mirdej/tvtools/maxmsp/Support/DSC01300.JPG

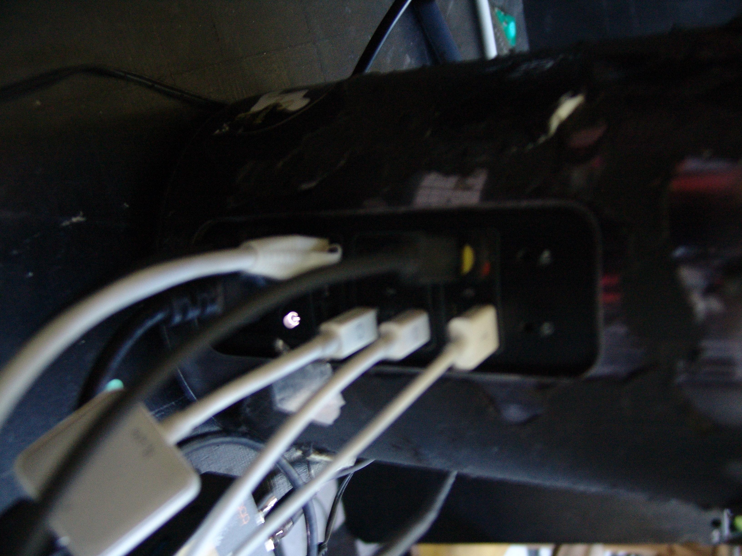
maxmsp/Support/DSC01300.JPG
