mirdej/tvtools/firmware/Lights/README.md

# Anyma ESP32-S3 Blink

Maybe the most complicated Arduino Blink Sketch in the world

## Dependencies
- FastLed: 	fastled/FastLED@^3.6.0
- ArduinoJSON: blanchon/ArduinoJson@^7.0.4
- aWOT Web server Library: 	lasselukkari/aWOT@^3.5.0
- FTP-Server: 	peterus/ESP-FTP-Server-Lib@^0.14.1
