mirdej/tvtools/kicad/tv.buzzer2022/tv.buzzer2022-Edge_Cuts.dxf

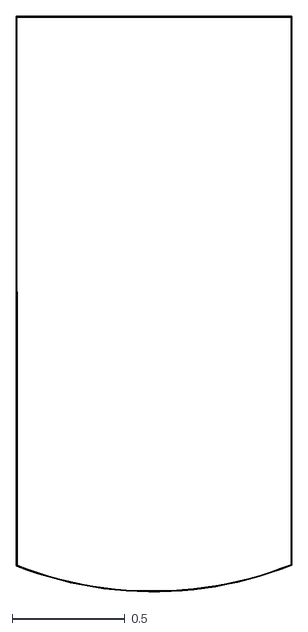
[picture p2: CAD file, 2024-05-06]
kicad/tv.buzzer2022/tv.buzzer2022-Edge_Cuts.dxf
1.22 x 2.55
