mirdej/tvtools/kicad/tv.buzzer3.0/buzzer3.0-B_Cu.dxf

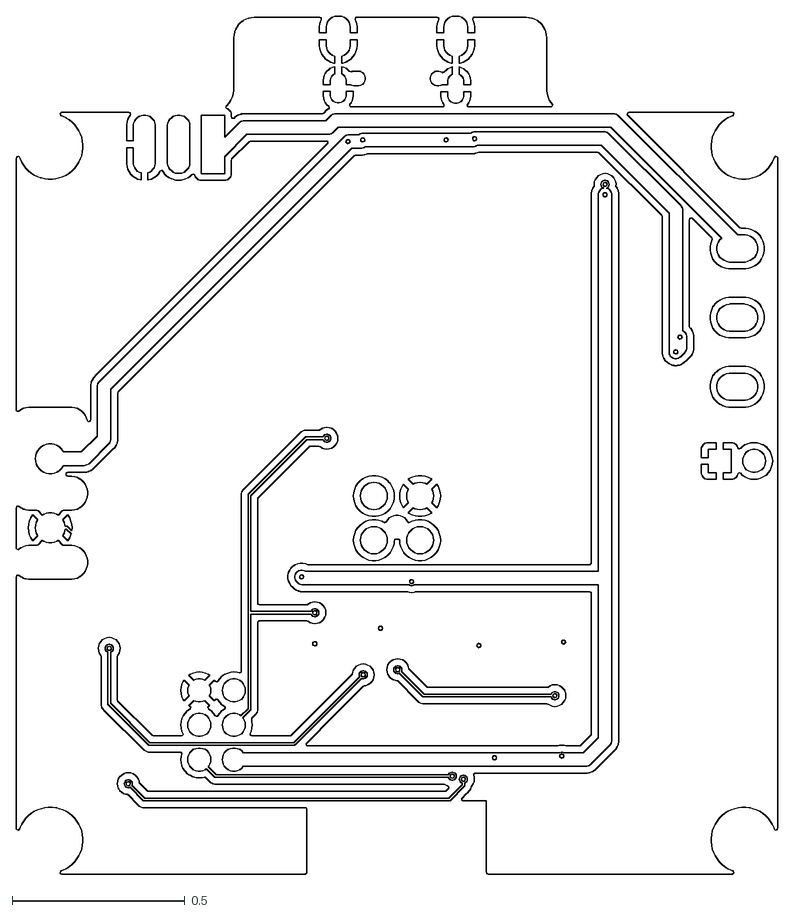
[picture p3: CAD file, 2025-04-22]
kicad/tv.buzzer3.0/buzzer3.0-B_Cu.dxf
2.20 x 2.48
