mirdej/tvtools/sketchup/steckerschlange6-flex-smaller.3mf

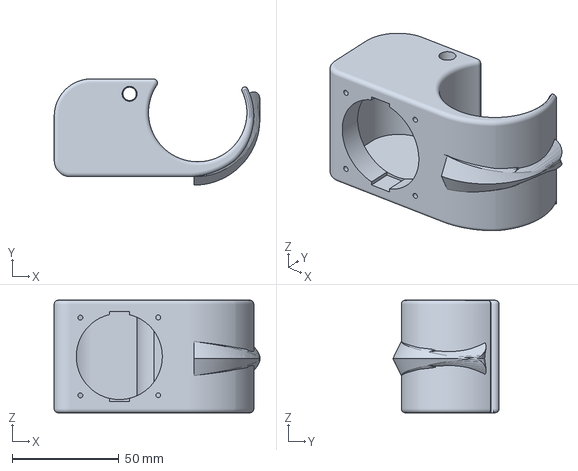
[picture p4: CAD file, 2024-05-06]
sketchup/steckerschlange6-flex-smaller.3mf
96.6 x 49.8 x 52.8 mm
