mirdej/tvtools/kicad/tv.buzzer2022/tv.buzzer2022-B_Cu.dxf

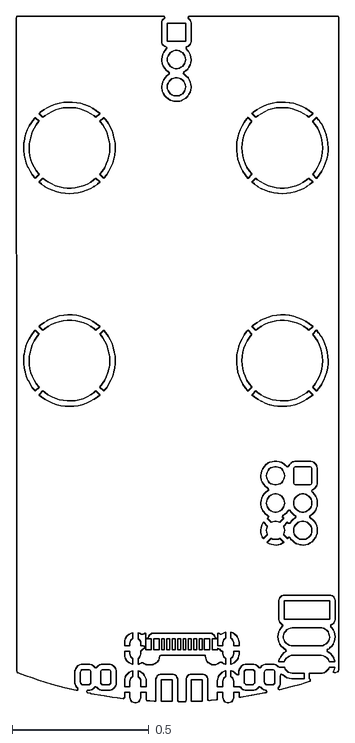
[picture p5: CAD file, 2024-05-06]
kicad/tv.buzzer2022/tv.buzzer2022-B_Cu.dxf
1.18 x 2.51
