mirdej/tvtools/sketchup/steckerschlange6-flex-smaller2.stl

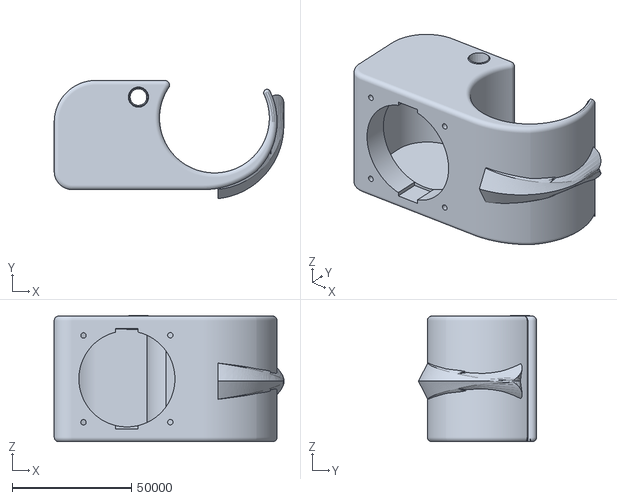
[picture p7: CAD file, 2024-05-06]
sketchup/steckerschlange6-flex-smaller2.stl
96590.7 x 49657.1 x 53116.8
