mirdej/tvtools/kicad/tv.buzzer2022/tv.buzzer2022-F_Cu.dxf

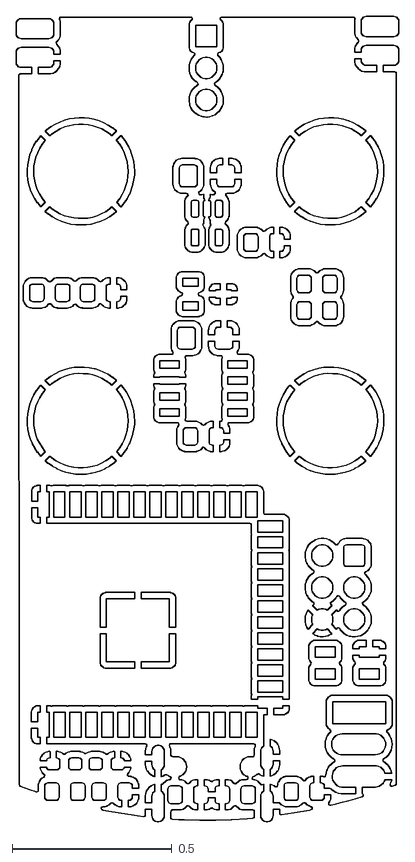
[picture p8: CAD file, 2024-05-06]
kicad/tv.buzzer2022/tv.buzzer2022-F_Cu.dxf
1.20 x 2.52
