mirdej/tvtools/kicad/tv.buzzer3.0/buzzer3.0-Edge_Cuts.dxf

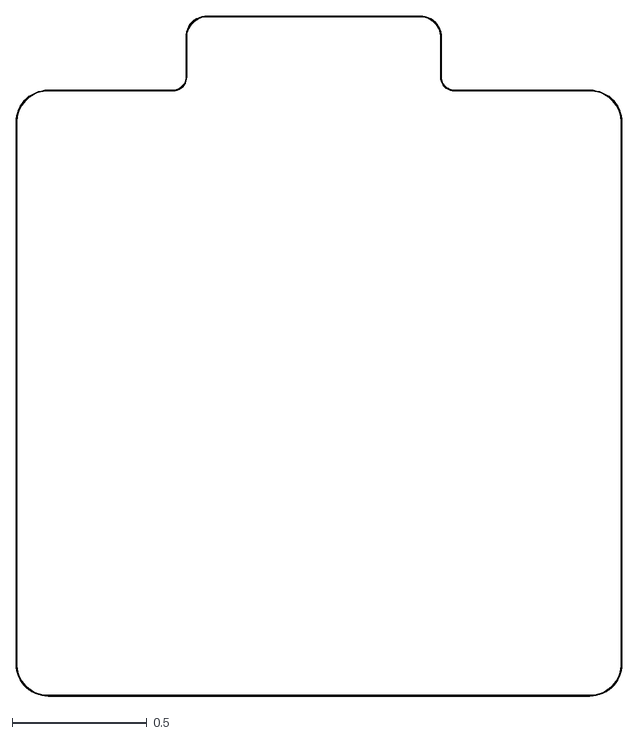
[picture p9: CAD file, 2025-04-22]
kicad/tv.buzzer3.0/buzzer3.0-Edge_Cuts.dxf
2.25 x 2.52
