mirdej/tvtools/(list of files, cad)

Other CAD files:
kicad/tv.buzzer2022/tv.buzzer2022-B_Mask.dxf
kicad/tv.buzzer2022/tv.buzzer2022-B_Paste.dxf
kicad/tv.buzzer2022/tv.buzzer2022-B_Silkscreen.dxf
kicad/tv.buzzer2022/tv.buzzer2022-F_Mask.dxf
kicad/tv.buzzer2022/tv.buzzer2022-F_Paste.dxf
kicad/tv.buzzer2022/tv.buzzer2022-F_Silkscreen.dxf
kicad/tv.buzzer3.0/buzzer3.0-B_Mask.dxf
kicad/tv.buzzer3.0/buzzer3.0-B_Paste.dxf
kicad/tv.buzzer3.0/buzzer3.0-B_Silkscreen.dxf
kicad/tv.buzzer3.0/buzzer3.0-F_Mask.dxf
kicad/tv.buzzer3.0/buzzer3.0-F_Paste.dxf
kicad/tv.buzzer3.0/buzzer3.0-F_Silkscreen.dxf
sketchup/ClipController23.skp
sketchup/ClipController23~.skp
sketchup/RecorderRack.skp
sketchup/SwitcherController-Enclosure.skp
sketchup/steckerschlange6-flex-smaller.skp
