mirdej/tvtools/kicad/DeckController-Hardware/DeckController-Hardware-B.Cu.pdf

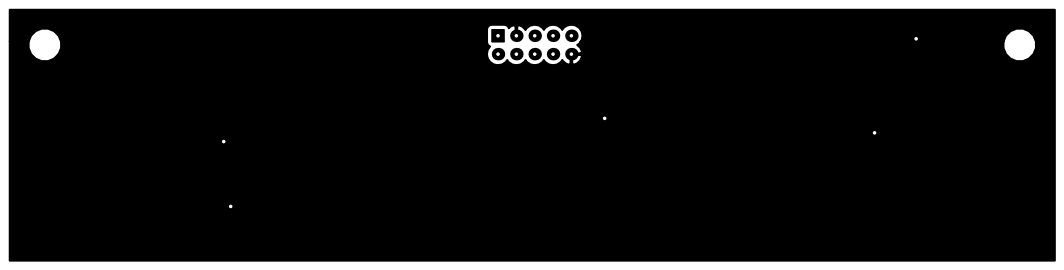
[picture p10: page 1]
