mirdej/tvtools/kicad/DeckController-Hardware/DeckController-Hardware-F.Cu.pdf

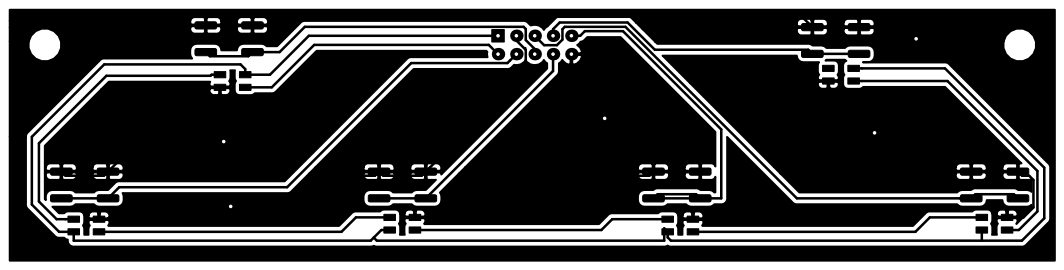
[picture p11: page 1]
