mirdej/tvtools/kicad/DeckController-Hardware/DeckController-Hardware-F.Mask.pdf

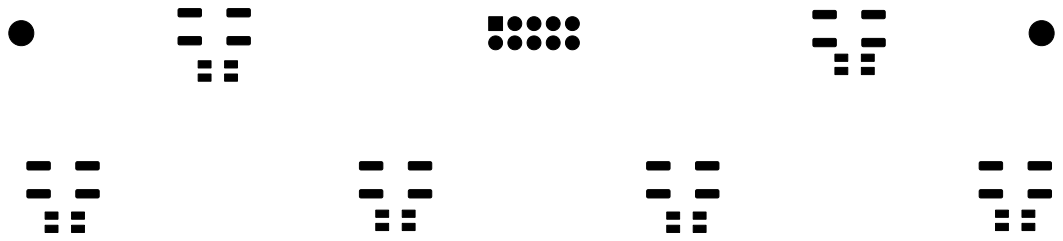
[picture p12: page 1]
