mirdej/tvtools/kicad/DeckController-Hardware/DeckController-Hardware-F.Paste.pdf

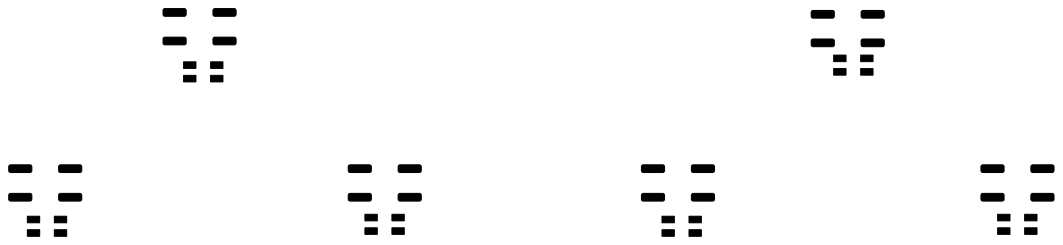
[picture p13: page 1]
