mirdej/tvtools/kicad/DeckController-Hardware/DeckController-Hardware-F.SilkS.pdf

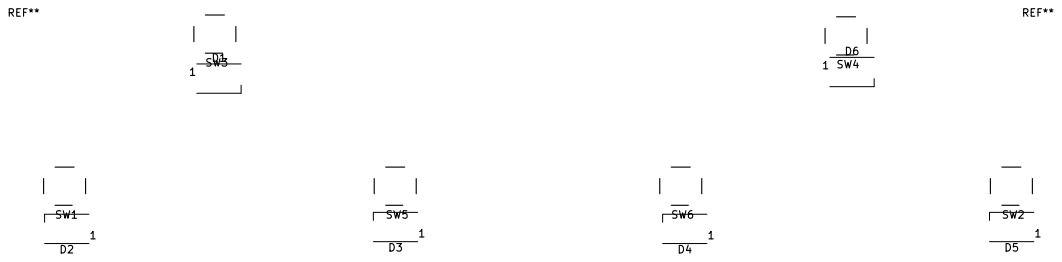
[picture p14: page 1]
