mirdej/tvtools/kicad/tv.controller2025/tv25-cpu-small/tv25-cpu-small.kicad_pcb

## KiCad design kicad/tv.controller2025/tv25-cpu-small/tv25-cpu-small.kicad_pcb (2025-05-29)

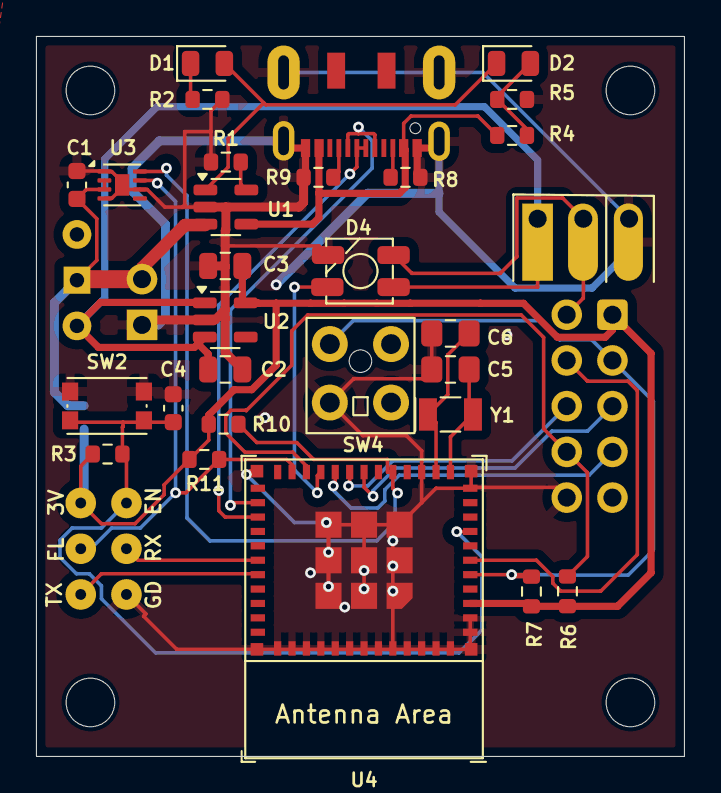
[picture p15: board tv25-cpu-small.kicad_pcb from above]

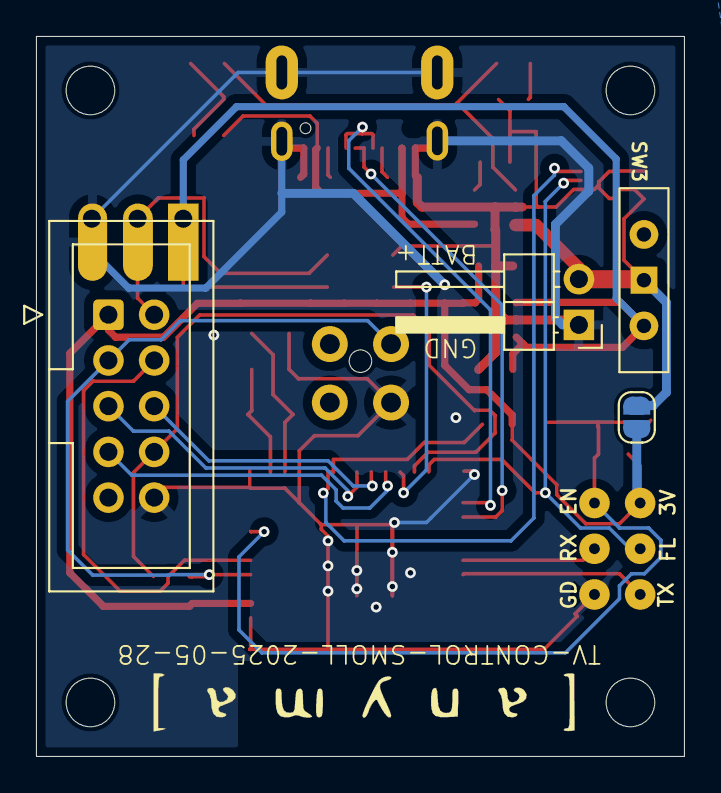
[picture p16: board tv25-cpu-small.kicad_pcb from below]

Board: 2 copper layers, 36.0 x 40.0 mm, 39 parts (5 on the bottom side), 28 nets.

Parts:
C1: 100n; C_0603_1608Metric
C2: 10u; C_0805_2012Metric
C3: 4u7; C_0805_2012Metric
C4: 1u; C_0603_1608Metric
C5, C6: 10p; C_0805_2012Metric_Pad1.18x1.45mm_HandSolder
D1: RDY; LED_0805_2012Metric
D2: CHRG; LED_0805_2012Metric
D4: SK6812MINI; SK6812-MINI-HS
H1, H2, H3, H4: MountingHole; MountingHole_2.7mm_M2.5
J1: BATT; PinHeader_1x02_P2.54mm_Horizontal
J2: Conn_01x10; IDC-Header_2x05_P2.54mm_Vertical
J3: Prog; ESP-POGO-PROG-THT
J4: USB_C_Receptacle_USB2.0; JAE_USB-C_SJ122205
J11: pixels; ComboPinhead_03
JP1: cell-powered; SolderJumper-2_P1.3mm_Open_RoundedPad1.0x1.5mm
R1, R2, R4, R5: 2k; R_0603_1608Metric
R3, R6, R7, R8, R9, R10, R11: 5k1; R_0603_1608Metric
SW2: Reset; SW_Push_1P1T_NO_CK_KMR2
SW3: SW_SPDT; SW_Slide-03_Wuerth-WS-SLTV_10x2.5x6.4_P2.54mm
SW4: Btn-1; DDS001
U1: MCP73831-2-OT; SOT-23-5
U2: XC6220B331MR; SOT-23-5
U3: TDFN-8-1EP_2x2mm_P0.5mm_EP0.8x1.2mm
U4: ESP32-C3-MINI-1
U5: LOGO; logo_anyma
Y1: 32.768khz; Crystal_SMD_G8-2Pin_3.2x1.5mm

Connections:
+3V3: C3.1, J2.1, J3.1, JP1.2 (B), R3.1, R6.1, R7.1, R10.1, R11.1, U2.5 (VOUT), U4.3 (3V3)
+3V8: C2.1, D4.4 (VDD), J11.1, SW3.2 (B), U2.1 (VIN), U2.3 (CE)
+5V: J4.A4 (VBUS), J4.A9 (VBUS), R4.1, U1.4 (VDD)
+BATT: C1.1, J1.2, JP1.1 (A), SW3.1 (A), U1.3 (VBAT), U3.2 (CELL), U3.3 (VDD)
/en: C4.1, J3.2, R3.2, SW2.2, U4.8 (EN/CHIP_PU)
/gpio_8: J2.8, R6.2, U4.22 (GPIO8)
/pix: D4.3 (DIN), U4.21 (GPIO7)
/pixout: D4.1 (DOUT), J2.2, J11.2
/rx: J3.4, U4.30 (GPIO20/U0RXD)
/scl/flash: J3.3, R11.2, U3.7 (SCL), U4.23 (GPIO9)
/sda: R10.2, U3.8 (SDA), U4.16 (GPIO10)
/strap2: J2.3, R7.2, SW4.1, U4.5 (GPIO2/ADC1_CH2)
/tx: J3.5, U4.31 (GPIO21/U0TXD)
/usb+: J4.A6 (D+), J4.B6 (D+), U4.27 (GPIO19/USB_D+)
/usb-: J4.A7 (D-), J4.B7 (D-), U4.26 (GPIO18/USB_D-)
GND: C1.2, C2.2, C3.2, C4.2, C5.1, C6.1, D4.2 (VSS), J1.1, J2.10, J3.6, J4.A1 (GND), J4.A12 (GND), J4.S1 (SHIELD), J11.3, R1.2, R2.2, R5.2, R8.2, R9.2, SW2.1, SW4.2, U1.2 (VSS), U2.2 (GND), U3.1 (CTG), U3.4 (GND), U3.6 (QSTRT), U3.9 (EP), U4.1 (GND), U4.2 (GND), U4.11 (GND), U4.14 (GND), U4.36 (GND), U4.37 (GND), U4.38 (GND), U4.39 (GND), U4.40 (GND), U4.41 (GND), U4.42 (GND), U4.43 (GND), U4.44 (GND), U4.45 (GND), U4.46 (GND), U4.47 (GND), U4.48 (GND), U4.49 (GND), U4.50 (GND), U4.51 (GND), U4.52 (GND), U4.53 (GND)
unnamed: D1.2 (A), D2.1 (K), U1.1 (STAT)
unnamed: D1.1 (K), R2.1
unnamed: D2.2 (A), R4.2, R5.1
unnamed: J2.4, U4.6 (GPIO3/ADC1_CH3)
unnamed: J2.5, U4.18 (GPIO4/ADC1_CH4)
unnamed: J2.6, U4.19 (GPIO5/ADC2_CH0)
unnamed: J2.7, U4.20 (GPIO6)
unnamed: J4.A5 (CC1), R8.1
unnamed: J4.B5 (CC2), R9.1
unnamed: R1.1, U1.5 (PROG)
unnamed: C5.2, U4.12 (GPIO0/ADC1_CH0/XTAL_32K_P), Y1.2
unnamed: C6.2, U4.13 (GPIO1/ADC1_CH1/XTAL_32K_N), Y1.1
