mirdej/tvtools/kicad/tv.controller2025/tv25-cpu/tv25-cpu.kicad_pcb

## KiCad design kicad/tv.controller2025/tv25-cpu/tv25-cpu.kicad_pcb (2025-04-22)

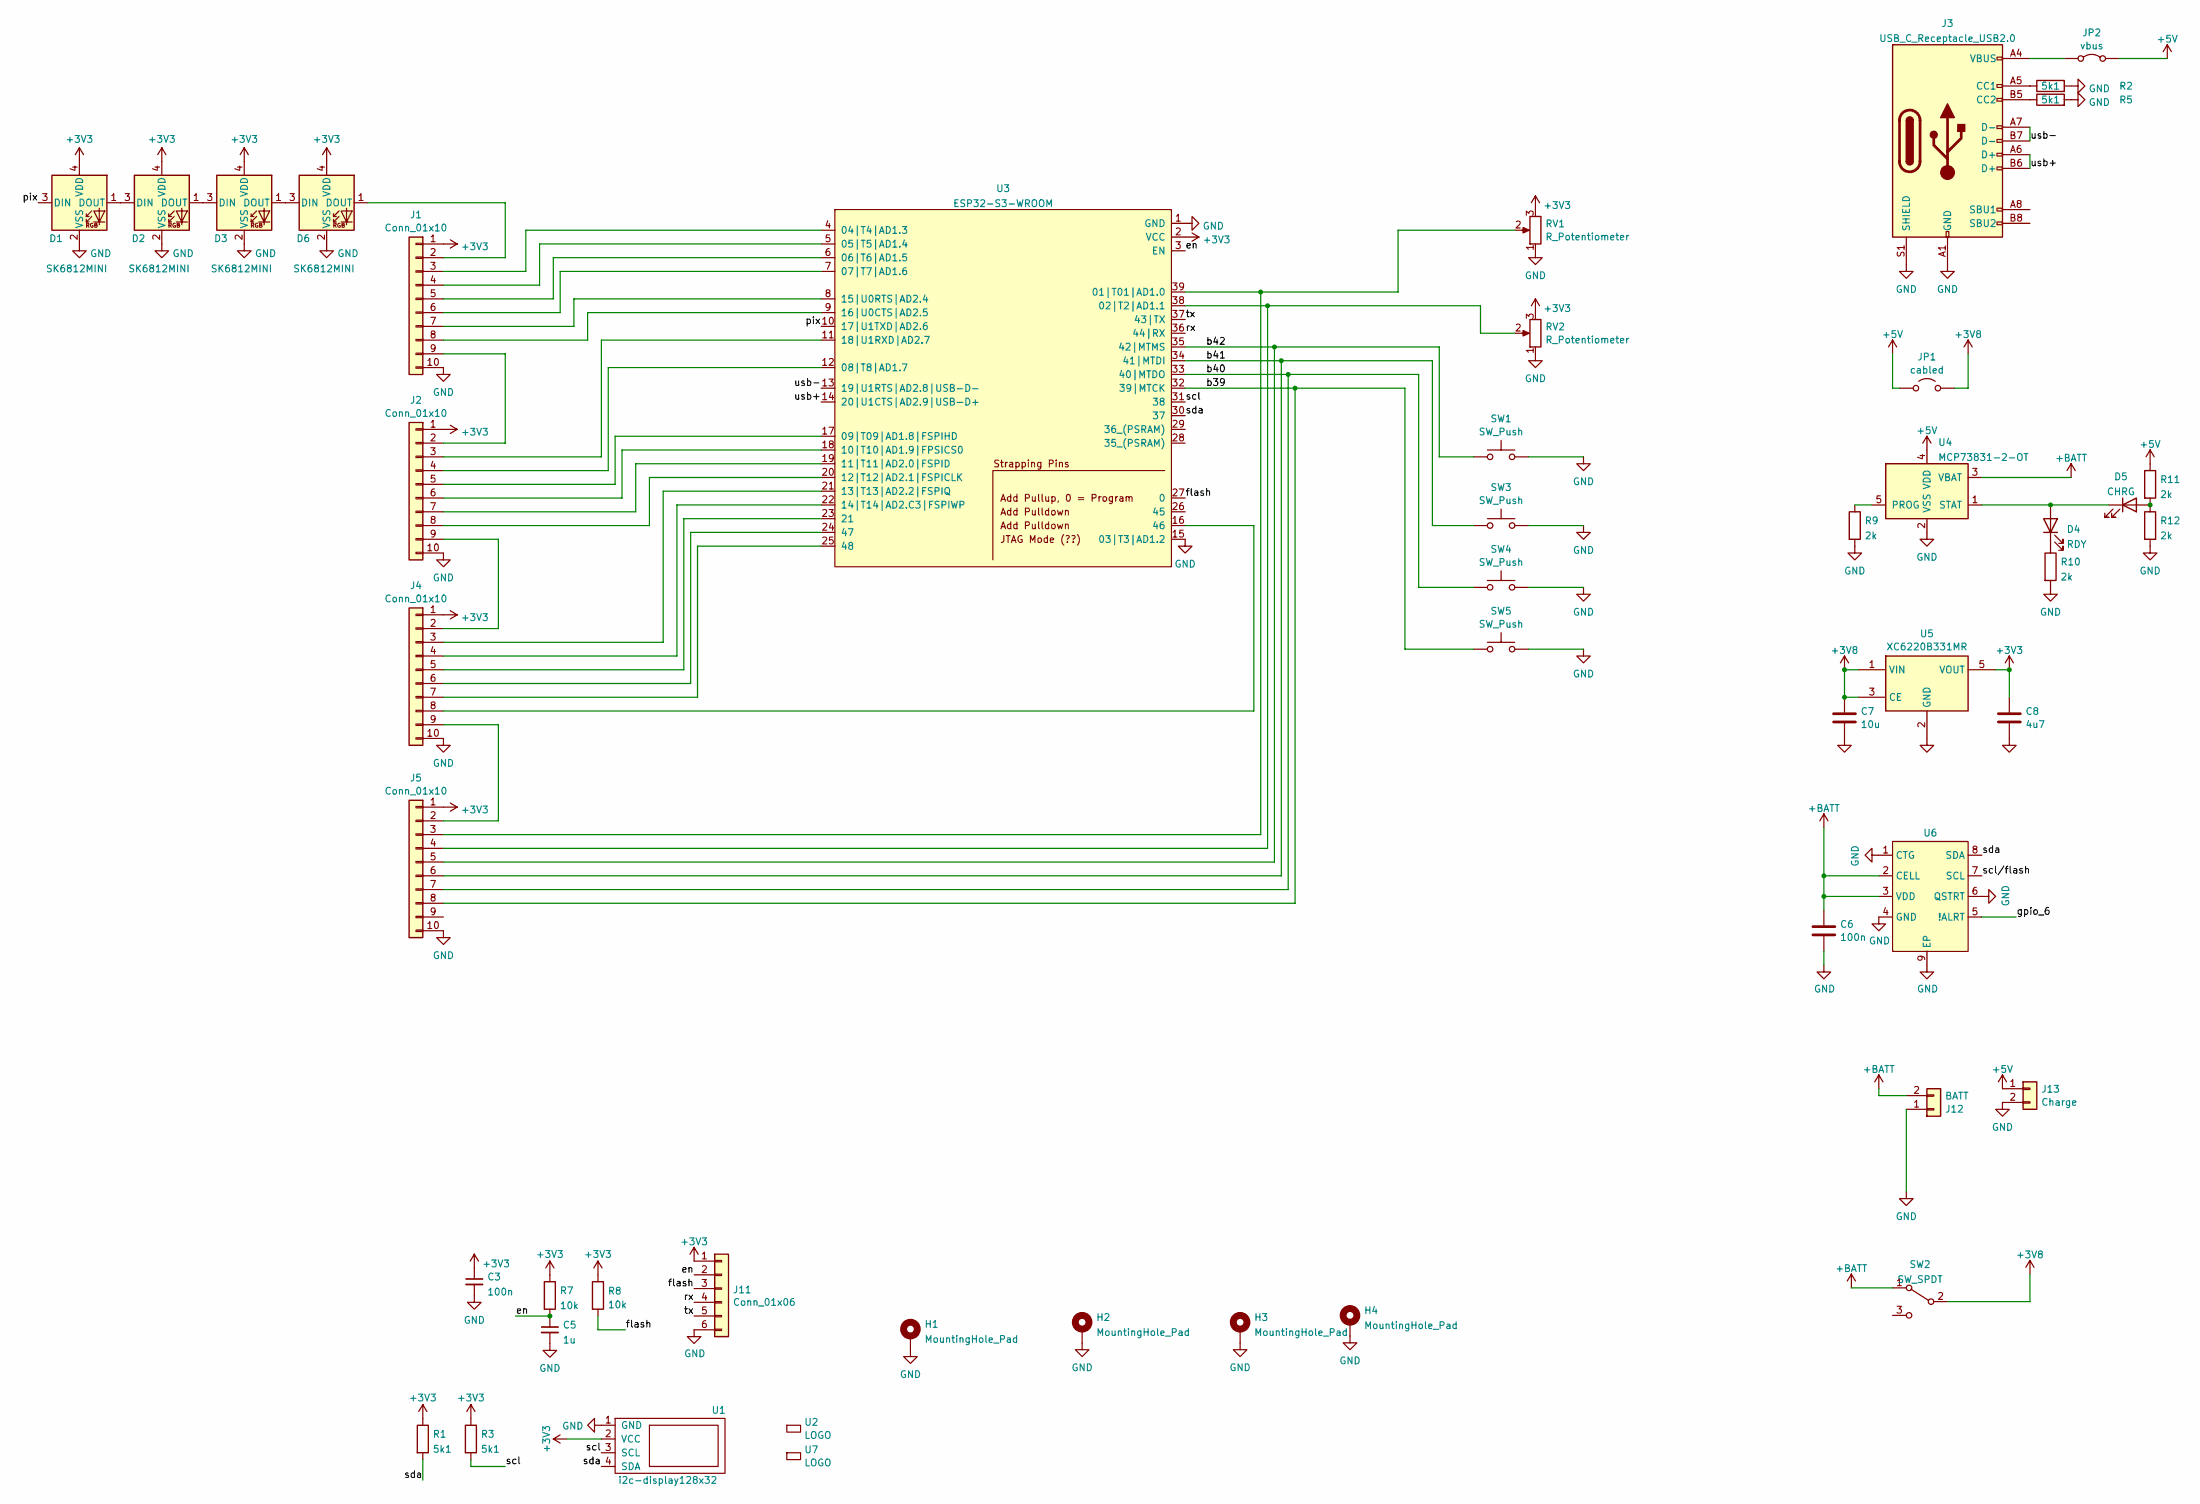
[picture p17: schematic tv25-cpu.kicad_sch]

Parts:
C3: 100n; C_0603_1608Metric_Pad1.05x0.95mm_HandSolder
C5: 1u; C_0603_1608Metric_Pad1.05x0.95mm_HandSolder
C6: 100n; C_0603_1608Metric
C7: 10u; C_0805_2012Metric
C8: 4u7; C_0805_2012Metric
D1, D2, D3, D6: SK6812MINI; LED_SK6812MINI_PLCC4_3.5x3.5mm_P1.75mm
D4: RDY; LED_0805_2012Metric
D5: CHRG; LED_0805_2012Metric
H1, H2, H3, H4: MountingHole_Pad; MountingHole_2.5mm_Pad
J1, J2, J4, J5: Conn_01x10; IDC-Header_2x05_P2.54mm_Vertical
J3: USB_C_Receptacle_USB2.0; JAE_USB-C_SJ122205
J11: Conn_01x06; PinHeader_1x06_P2.54mm_Vertical
J12: BATT; PinHeader_1x02_P2.54mm_Horizontal
J13: Charge; PogoChargeConn
JP1: cabled; SolderJumper-2_P1.3mm_Open_RoundedPad1.0x1.5mm
JP2: vbus; SolderJumper-2_P1.3mm_Bridged2Bar_RoundedPad1.0x1.5mm
R1, R3: 5k1; R_0805_2012Metric
R2, R5: 5k1; R_0805_2012Metric_Pad1.15x1.40mm_HandSolder
R7, R8: 10k; R_0805_2012Metric_Pad1.15x1.40mm_HandSolder
R9, R10, R11, R12: 2k; R_0603_1608Metric
RV1, RV2: R_Potentiometer; Potentiometer_Alps_RK09K_Single_Vertical
SW1, SW3, SW4, SW5: SW_Push; SW_Tactile_SPST_NO_Straight_CK_PTS636Sx25SMTRLFS
SW2: SW_SPDT; Microschalter
U1: i2c-display128x32; Bangood_I2C_Display
U2, U7: LOGO; logo_anyma_tiny
U3: ESP32-S3-WROOM
U4: MCP73831-2-OT; SOT-23-5
U5: XC6220B331MR; SOT-23-5
U6: TDFN-8-1EP_2x2mm_P0.5mm_EP0.8x1.2mm

Connections:
+3V3: C3.1, C8.1, D1.4 (VDD), D2.4 (VDD), D3.4 (VDD), D6.4 (VDD), J1.1, J2.1, J4.1, J5.1, J11.1, R1.1, R3.1, R7.1, R8.1, RV1.3, RV2.3, U1.2 (VCC), U3.2 (VCC), U5.5 (VOUT)
+3V8: C7.1, JP1.2 (B), SW2.2 (B), U5.1 (VIN), U5.3 (CE)
+5V: J13.1, JP1.1 (A), JP2.2 (B), R11.1, U4.4 (VDD)
+BATT: C6.1, J12.2, SW2.1 (A), U4.3 (VBAT), U6.2 (CELL), U6.3 (VDD)
/b39: J5.8, SW5.1, U3.32 (39|MTCK)
/b40: J5.7, SW4.1, U3.33 (40|MTDO)
/b41: J5.6, SW3.1, U3.34 (41|MTDI)
/b42: J5.5, SW1.1, U3.35 (42|MTMS)
/en: C5.1, J11.2, R7.2, U3.3 (EN)
/flash: J11.3, R8.2, U3.27 (0)
/gpio_6: U6.5 (!ALRT)
/pix: D1.3 (DIN), U3.10 (17|U1TXD|AD2.6)
/rx: J11.4, U3.36 (44|RX)
/scl: R3.2, U1.3 (SCL), U3.31 (38)
/scl/flash: U6.7 (SCL)
/sda: R1.2, U1.4 (SDA), U3.30 (37), U6.8 (SDA)
/tx: J11.5, U3.37 (43|TX)
/usb+: J3.A6 (D+), J3.B6 (D+), U3.14 (20|U1CTS|AD2.9|USB-D+)
/usb-: J3.A7 (D-), J3.B7 (D-), U3.13 (19|U1RTS|AD2.8|USB-D-)
GND: C3.2, C5.2, C6.2, C7.2, C8.2, D1.2 (VSS), D2.2 (VSS), D3.2 (VSS), D6.2 (VSS), H1.1, H2.1, H3.1, H4.1, J1.10, J2.10, J3.A1 (GND), J3.A12 (GND), J3.B1 (GND), J3.B12 (GND), J3.S1 (SHIELD), J4.10, J5.10, J11.6, J12.1, J13.2, R2.2, R5.2, R9.2, R10.2, R12.2, RV1.1, RV2.1, SW1.2, SW3.2, SW4.2, SW5.2, U1.1 (GND), U3.1 (GND), U3.15 (03|T3|AD1.2), U3.40 (GND), U3.41 (GND), U4.2 (VSS), U5.2 (GND), U6.1 (CTG), U6.4 (GND), U6.6 (QSTRT), U6.9 (EP)
unnamed: D1.1 (DOUT), D2.3 (DIN)
unnamed: D2.1 (DOUT), D3.3 (DIN)
unnamed: D3.1 (DOUT), D6.3 (DIN)
unnamed: D4.2 (A), D5.1 (K), U4.1 (STAT)
unnamed: D4.1 (K), R10.1
unnamed: D5.2 (A), R11.2, R12.1
unnamed: D6.1 (DOUT), J1.2
unnamed: J1.3, U3.4 (04|T4|AD1.3)
unnamed: J1.4, U3.5 (05|T5|AD1.4)
unnamed: J1.5, U3.6 (06|T6|AD1.5)
unnamed: J1.6, U3.7 (07|T7|AD1.6)
unnamed: J1.7, U3.8 (15|U0RTS|AD2.4)
unnamed: J1.8, U3.9 (16|U0CTS|AD2.5)
unnamed: J1.9, J2.2
unnamed: J2.3, U3.11 (18|U1RXD|AD2.7)
unnamed: J2.4, U3.12 (08|T8|AD1.7)
unnamed: J2.5, U3.17 (09|T09|AD1.8|FSPIHD)
unnamed: J2.6, U3.18 (10|T10|AD1.9|FPSICS0)
unnamed: J2.7, U3.19 (11|T11|AD2.0|FSPID)
unnamed: J2.8, U3.20 (12|T12|AD2.1|FSPICLK)
unnamed: J2.9, J4.2
unnamed: J3.A5 (CC1), R2.1
unnamed: J3.B5 (CC2), R5.1
unnamed: J4.3, U3.21 (13|T13|AD2.2|FSPIQ)
unnamed: J4.4, U3.22 (14|T14|AD2.C3|FSPIWP)
unnamed: J4.5, U3.23 (21)
unnamed: J4.6, U3.24 (47)
unnamed: J4.7, U3.25 (48)
unnamed: J4.8, U3.16 (46)
unnamed: J4.9, J5.2
unnamed: J5.3, RV1.2, U3.39 (01|T01|AD1.0)
unnamed: J5.4, RV2.2, U3.38 (02|T2|AD1.1)
unnamed: J3.A4 (VBUS), J3.A9 (VBUS), J3.B4 (VBUS), J3.B9 (VBUS), JP2.1 (A)
unnamed: R9.1, U4.5 (PROG)

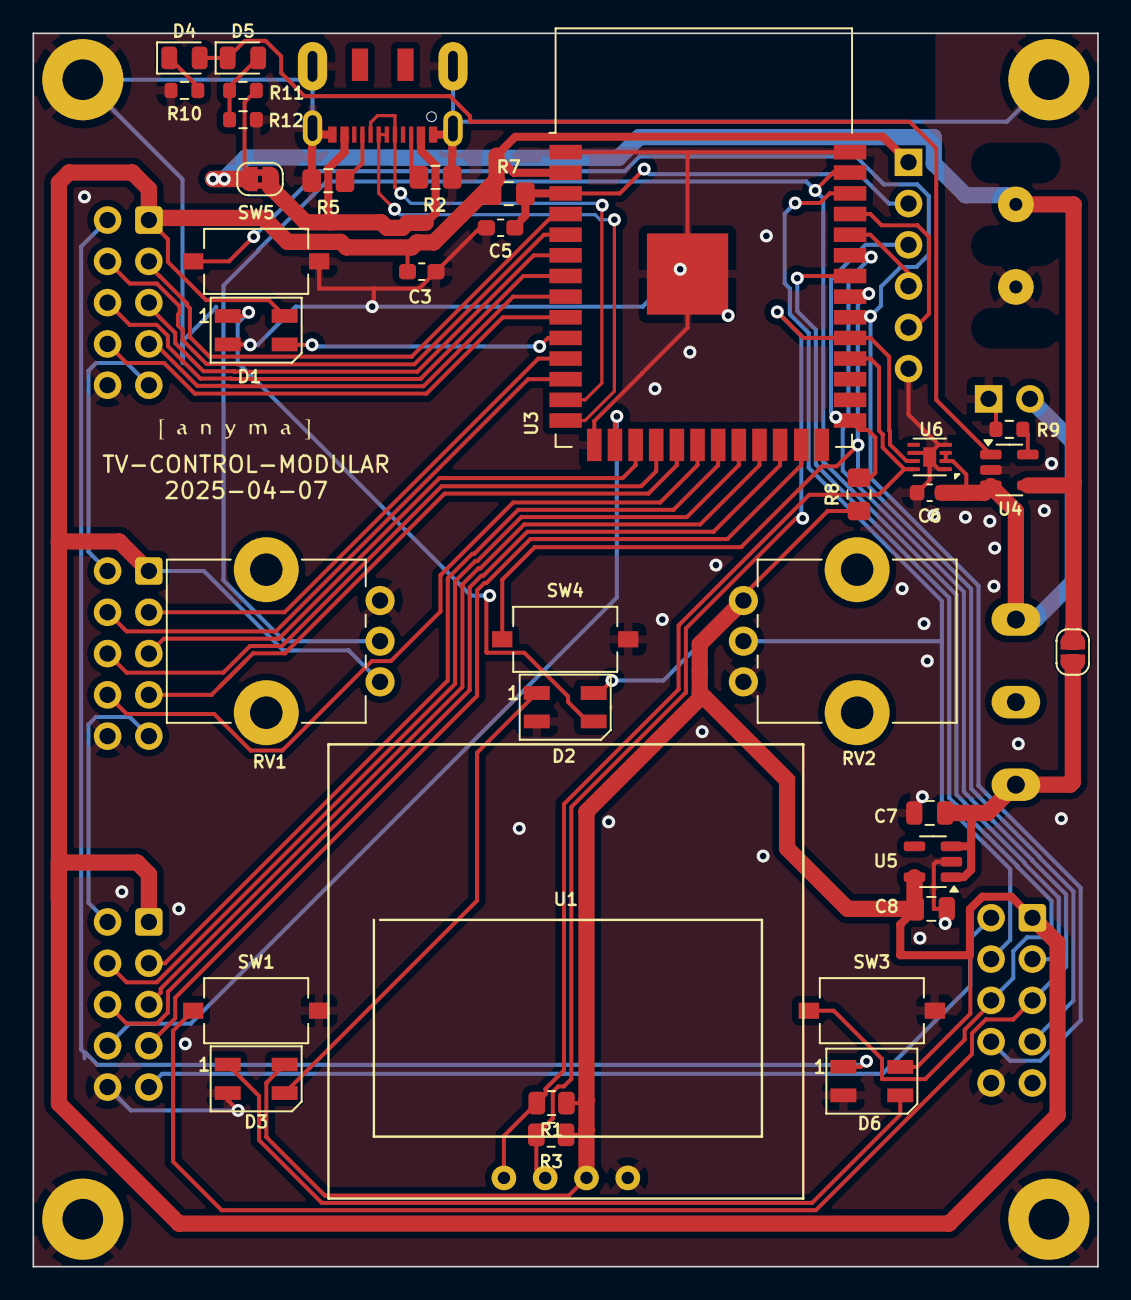
[picture p18: board tv25-cpu.kicad_pcb from above]

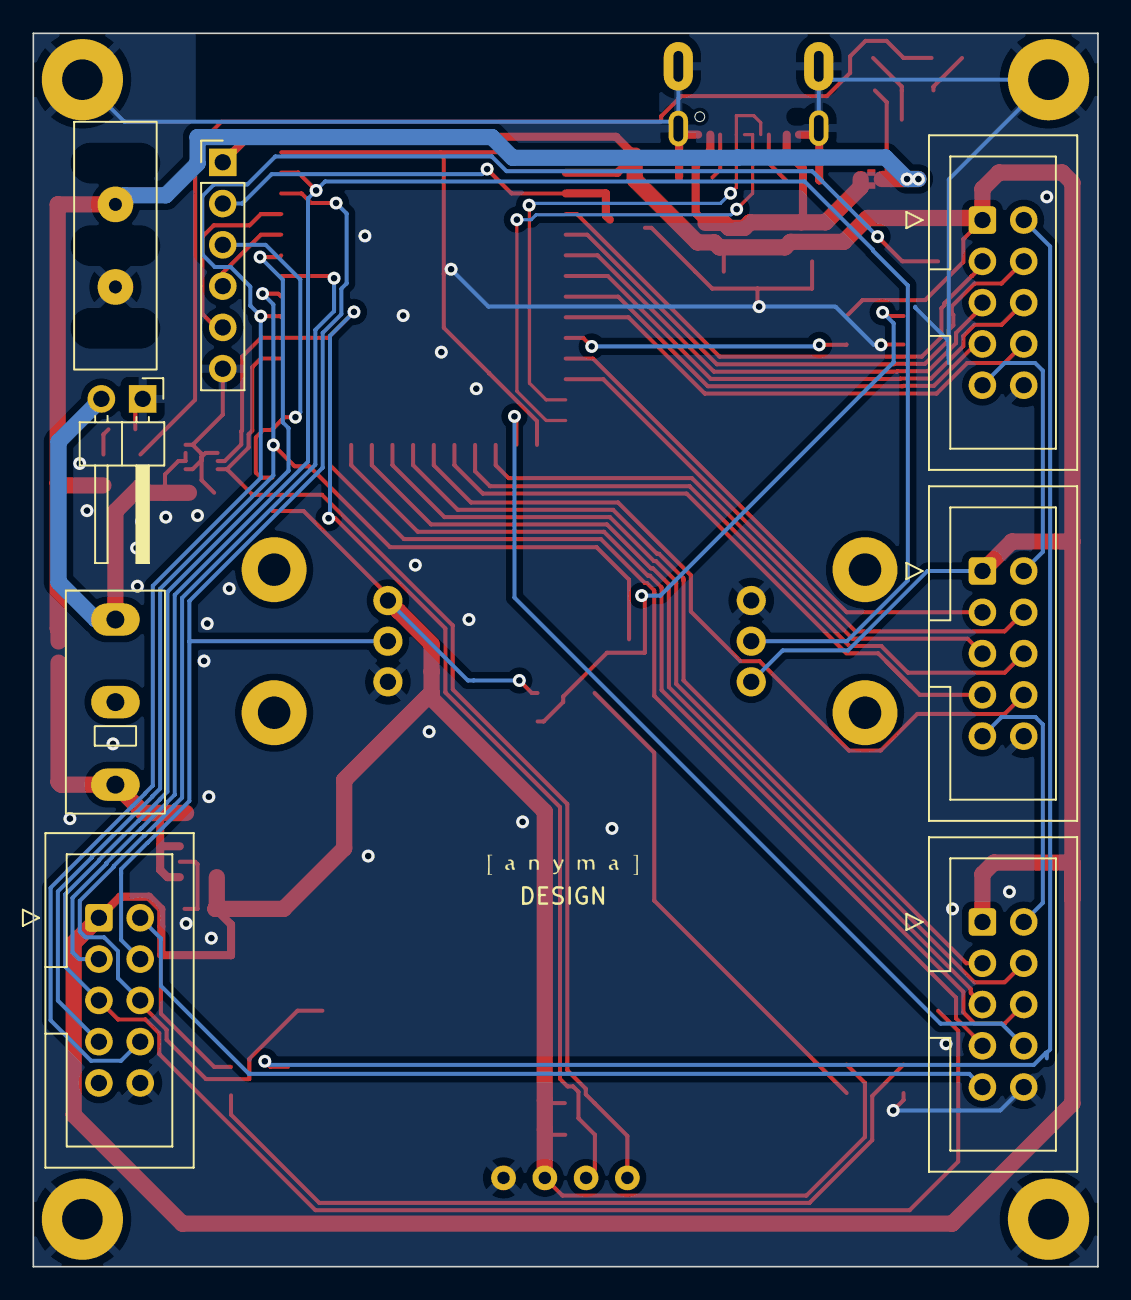
[picture p19: board tv25-cpu.kicad_pcb from below]

Board: 2 copper layers, 65.5 x 75.9 mm, 49 parts (9 on the bottom side), 52 nets.
