mirdej/tvtools/kicad/tv.controller2025/tv25-rotary/tv25-rotary.kicad_pcb

## KiCad design kicad/tv.controller2025/tv25-rotary/tv25-rotary.kicad_pcb (2025-04-22)

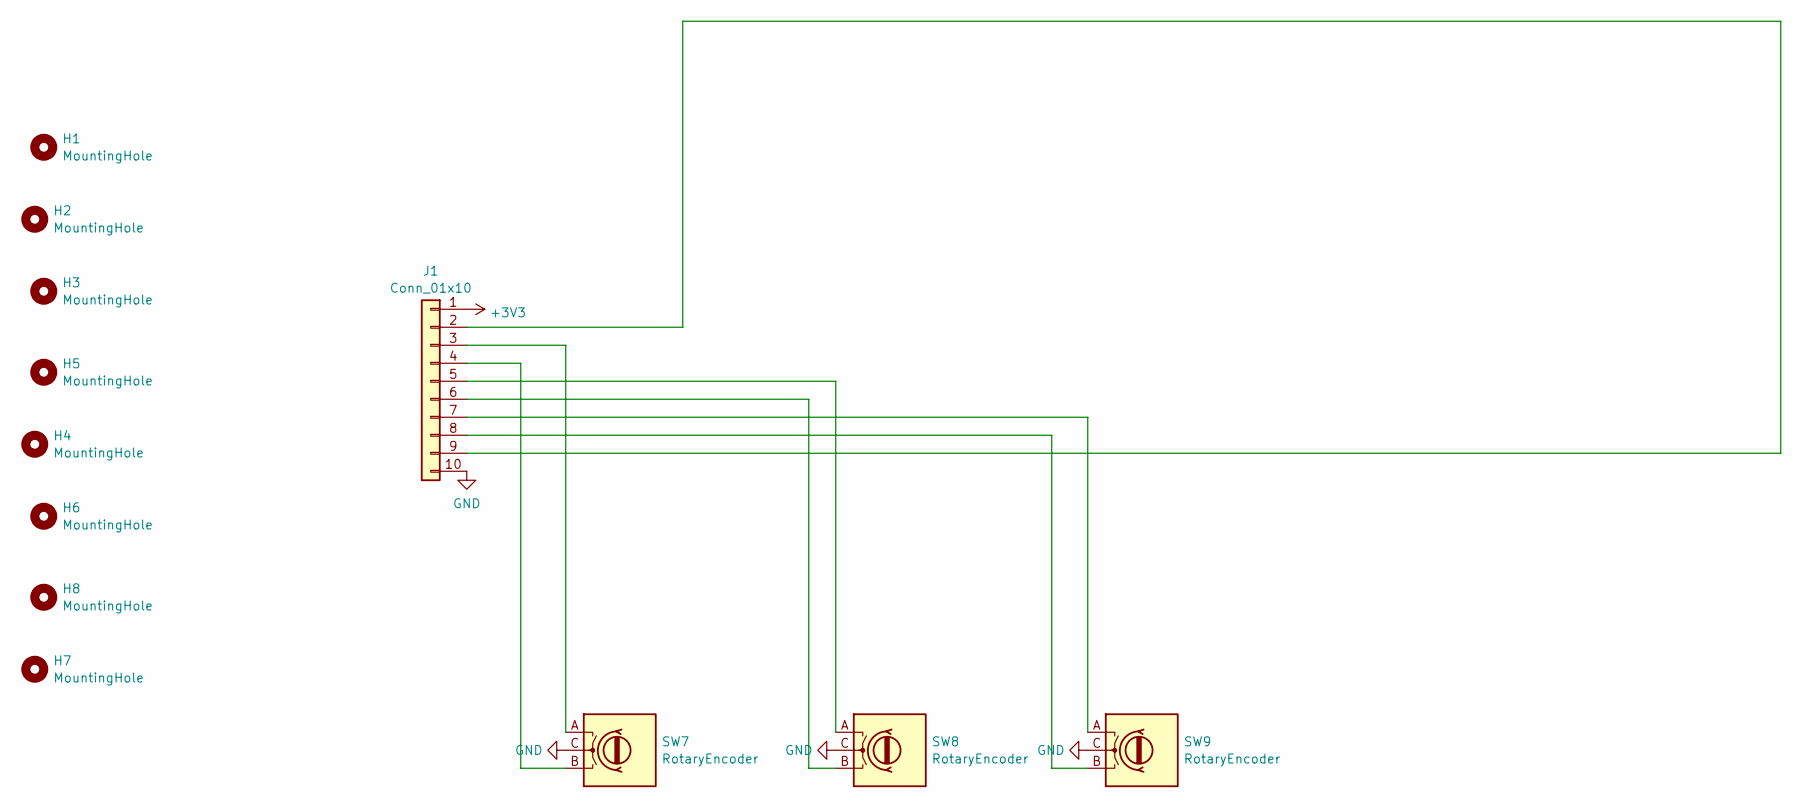
[picture p20: schematic tv25-rotary.kicad_sch]

Parts:
H1, H2, H3, H4, H5, H6, H7, H8: MountingHole; MountingHole_3.2mm_M3
J1: Conn_01x10; IDC-Header_2x05_P2.54mm_Vertical
SW7, SW8, SW9: RotaryEncoder; RotaryEncoder_Alps_EC12E_HV-Combo

Connections:
+3V3: J1.1
GND: J1.10, SW7.C, SW8.C, SW9.C
unnamed: J1.2, J1.9
unnamed: J1.3, SW7.A
unnamed: J1.4, SW7.B
unnamed: J1.5, SW8.A
unnamed: J1.6, SW8.B
unnamed: J1.7, SW9.A
unnamed: J1.8, SW9.B

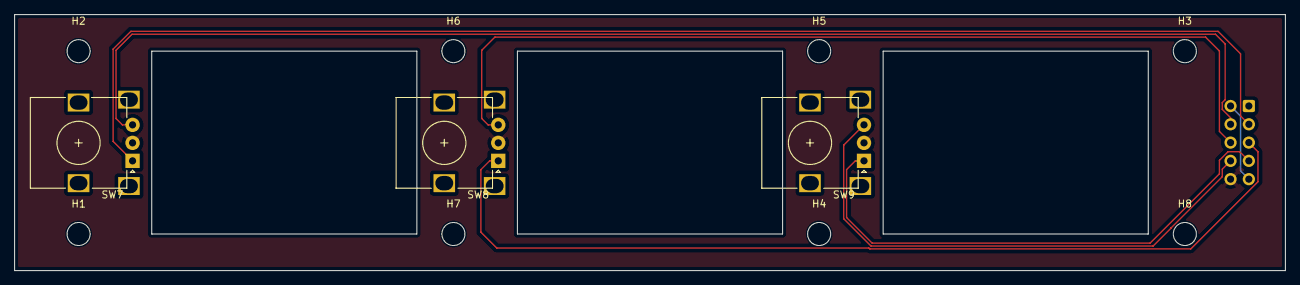
[picture p21: board tv25-rotary.kicad_pcb from above]

Board: 2 copper layers, 176.5 x 35.6 mm, 12 parts (1 on the bottom side), 8 nets.
