mirdej/tvtools/kicad/tv.controller2025/tv25-tbar/tv25-tbar.kicad_pcb

## KiCad design kicad/tv.controller2025/tv25-tbar/tv25-tbar.kicad_pcb (2025-04-22)

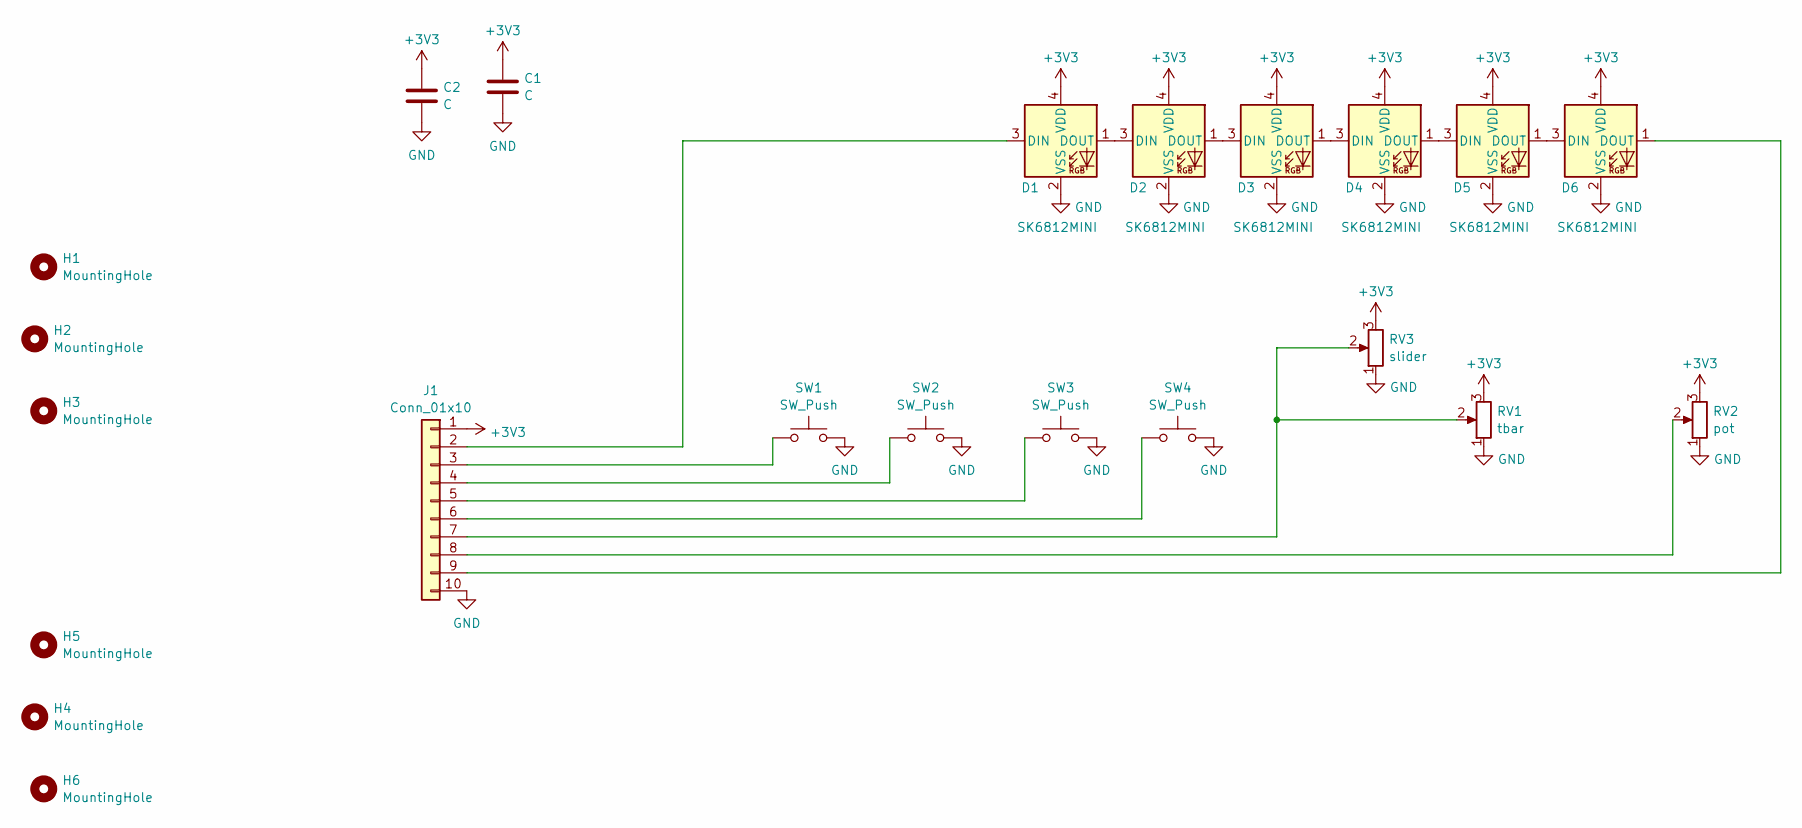
[picture p22: schematic tv25-tbar.kicad_sch]

Parts:
C1, C2: C; C_0603_1608Metric
D1, D2, D3, D4, D5, D6: SK6812MINI; LED_SK6812MINI_PLCC4_3.5x3.5mm_P1.75mm
H1, H2, H3, H4, H5, H6: MountingHole; MountingHole_3.2mm_M3
J1: Conn_01x10; IDC-Header_2x05_P2.54mm_Vertical
RV1: tbar; Potentiometer_Alps_RK09K_Single_Horizontal
RV2: pot; Potentiometer_Alps_RK09K_Single_Vertical
RV3: slider; Potentiometer_Alps_RS6011xP_Slide
SW1, SW2, SW3, SW4: SW_Push; SW_Tactile_SPST_NO_Straight_CK_PTS636Sx25SMTRLFS

Connections:
+3V3: C1.1, C2.1, D1.4 (VDD), D2.4 (VDD), D3.4 (VDD), D4.4 (VDD), D5.4 (VDD), D6.4 (VDD), J1.1, RV1.3, RV2.3, RV3.3
GND: C1.2, C2.2, D1.2 (VSS), D2.2 (VSS), D3.2 (VSS), D4.2 (VSS), D5.2 (VSS), D6.2 (VSS), J1.10, RV1.1, RV2.1, RV3.1, SW1.2, SW2.2, SW3.2, SW4.2
unnamed: D1.3 (DIN), J1.2
unnamed: D1.1 (DOUT), D2.3 (DIN)
unnamed: D2.1 (DOUT), D3.3 (DIN)
unnamed: D3.1 (DOUT), D4.3 (DIN)
unnamed: D4.1 (DOUT), D5.3 (DIN)
unnamed: D5.1 (DOUT), D6.3 (DIN)
unnamed: D6.1 (DOUT), J1.9
unnamed: J1.3, SW1.1
unnamed: J1.4, SW2.1
unnamed: J1.5, SW3.1
unnamed: J1.6, SW4.1
unnamed: J1.7, RV1.2, RV3.2
unnamed: J1.8, RV2.2

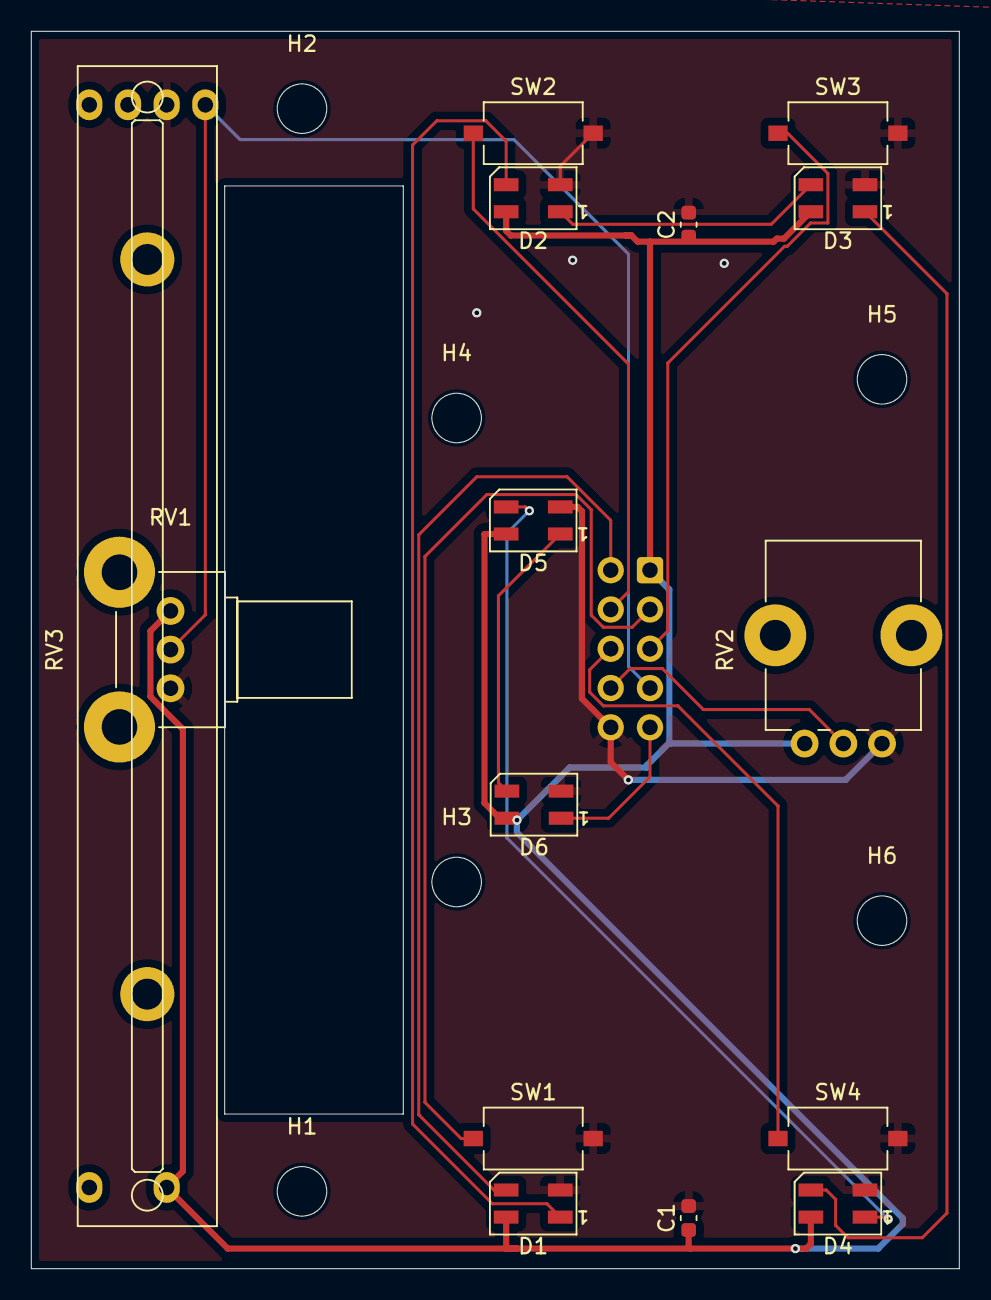
[picture p23: board tv25-tbar.kicad_pcb from above]

Board: 2 copper layers, 60.0 x 80.0 mm, 22 parts (1 on the bottom side), 15 nets.
