mirdej/tvtools/kicad/biuzzcharge/biuzzcharge.kicad_pcb

## KiCad design kicad/biuzzcharge/biuzzcharge.kicad_pcb (2025-04-22)

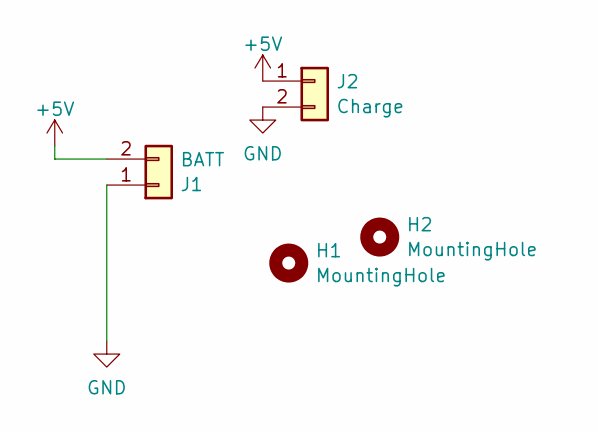
[picture p24: schematic biuzzcharge.kicad_sch]

Parts:
H1, H2: MountingHole; MountingHole_3.2mm_M3
J1: BATT; PinHeader_1x02_P2.54mm_Horizontal
J2: Charge; PogoChargeConn

Connections:
+5V: J1.2, J2.1
GND: J1.1, J2.2

Board: 2 copper layers, 4 parts (1 on the bottom side), 2 nets, no tracks yet.
