mirdej/tvtools/kicad/tv.controller2023/tv.controller2023.kicad_pcb

## KiCad design kicad/tv.controller2023/tv.controller2023.kicad_pcb (2024-05-15)

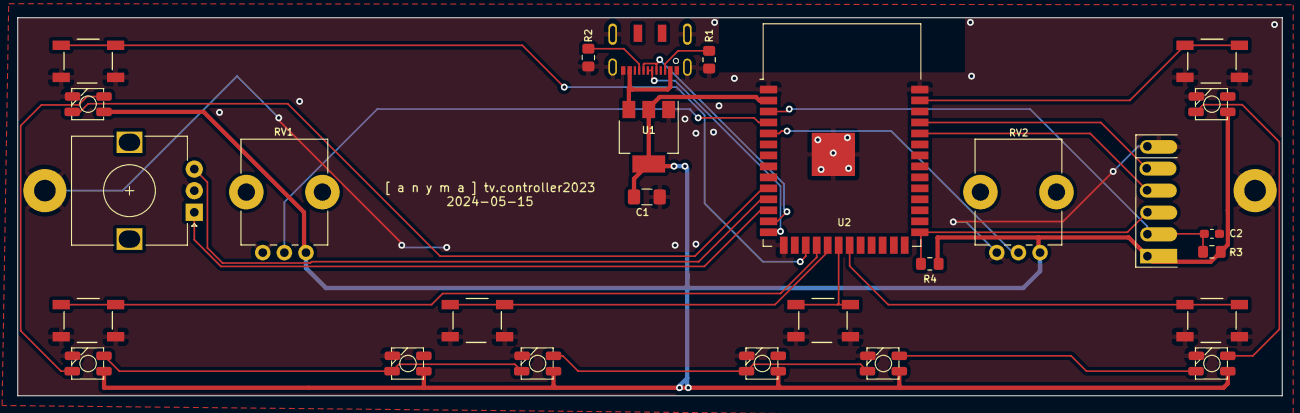
[picture p25: board tv.controller2023.kicad_pcb from above]

Board: 2 copper layers, 146.3 x 43.7 mm, 29 parts (0 on the bottom side), 27 nets.

Parts:
C1: 10u; C_1206_3216Metric_Pad1.42x1.75mm_HandSolder
C2: 1u; C_0603_1608Metric_Pad1.05x0.95mm_HandSolder
D1, D2, D3, D4, D5, D6, D7, D8: SK6812MINI; SK6812-MINI-HS
H1, H2: MountingHole_Pad; MountingHole_2.5mm_Pad
J1: USB_C_Receptacle_USB2.0; JAE_USB-C_SJ122205
J2: Conn_01x06; ComboPinhead_06
R1, R2: 5k1; R_0805_2012Metric_Pad1.15x1.40mm_HandSolder
R3, R4: 10k; R_0805_2012Metric_Pad1.15x1.40mm_HandSolder
RV1, RV2: R_Potentiometer; Potentiometer_Alps_RK09K_Single_Vertical
SW1, SW2, SW3, SW4, SW5, SW6: SW_Push; Alps_Tactile_Switch
SW7: RotaryEncoder; RotaryEncoder_Alps_EC12E_Vertical_H20mm
U1: AZ1117-3.3; SOT-223-3_TabPin2
U2: ESP32-S3-WROOM

Connections:
+3V3: C1.1, D1.4 (VDD), D2.4 (VDD), D3.4 (VDD), D4.4 (VDD), D5.4 (VDD), D6.4 (VDD), D7.4 (VDD), D8.4 (VDD), J2.1, R3.1, R4.1, RV1.1, RV2.1, U1.2 (VO), U2.2 (VCC)
+5V: J1.A4 (VBUS), J1.A9 (VBUS), U1.3 (VI)
/en: C2.1, J2.2, R3.2, U2.3 (EN)
/enc-1: SW7.A, U2.12 (08|T8|AD1.7)
/enc-2: SW7.B, U2.11 (18|U1RXD|AD2.7)
/flash: J2.3, R4.2, U2.27 (0)
/pix: D1.3 (DIN), U2.10 (17|U1TXD|AD2.6)
/rx: J2.4, U2.36 (44|RX)
/swi1: SW1.1, U2.17 (09|T09|AD1.8|FSPIHD)
/swi2: SW2.1, U2.18 (10|T10|AD1.9|FPSICS0)
/swi3: SW3.1, U2.19 (11|T11|AD2.0|FSPID)
/swi4: SW4.1, U2.20 (12|T12|AD2.1|FSPICLK)
/swi5: SW5.1, U2.21 (13|T13|AD2.2|FSPIQ)
/swi6: SW6.1, U2.39 (01|T01|AD1.0)
/tx: J2.5, U2.37 (43|TX)
/usb+: J1.A6 (D+), J1.B6 (D+), U2.14 (20|U1CTS|AD2.9|USB-D+)
/usb-: J1.A7 (D-), J1.B7 (D-), U2.13 (19|U1RTS|AD2.8|USB-D-)
GND: C1.2, C2.2, D1.2 (VSS), D2.2 (VSS), D3.2 (VSS), D4.2 (VSS), D5.2 (VSS), D6.2 (VSS), D7.2 (VSS), D8.2 (VSS), H1.1, H2.1, J1.A1 (GND), J1.A12 (GND), J1.S1 (SHIELD), J2.6, R1.2, R2.2, RV1.3, RV2.3, SW1.2, SW2.2, SW3.2, SW4.2, SW5.2, SW6.2, SW7.C, U1.1 (GND), U2.1 (GND), U2.15 (03|T3|AD1.2), U2.40 (GND), U2.41 (GND)
unnamed: D1.1 (DOUT), D2.3 (DIN)
unnamed: D2.1 (DOUT), D3.3 (DIN), D7.3 (DIN)
unnamed: D3.1 (DOUT), D4.3 (DIN), D8.3 (DIN)
unnamed: D4.1 (DOUT), D5.3 (DIN)
unnamed: D5.1 (DOUT), D6.3 (DIN)
unnamed: J1.A5 (CC1), R1.1
unnamed: J1.B5 (CC2), R2.1
unnamed: RV1.2, U2.4 (04|T4|AD1.3)
unnamed: RV2.2, U2.5 (05|T5|AD1.4)
