mirdej/tvtools/kicad/5port-headphone-belkin-clone-schnittplatz17./5port-headphone-belkin-clone-schnittplatz17.kicad_pcb

## KiCad design kicad/5port-headphone-belkin-clone-schnittplatz17./5port-headphone-belkin-clone-schnittplatz17.kicad_pcb (2024-05-15)

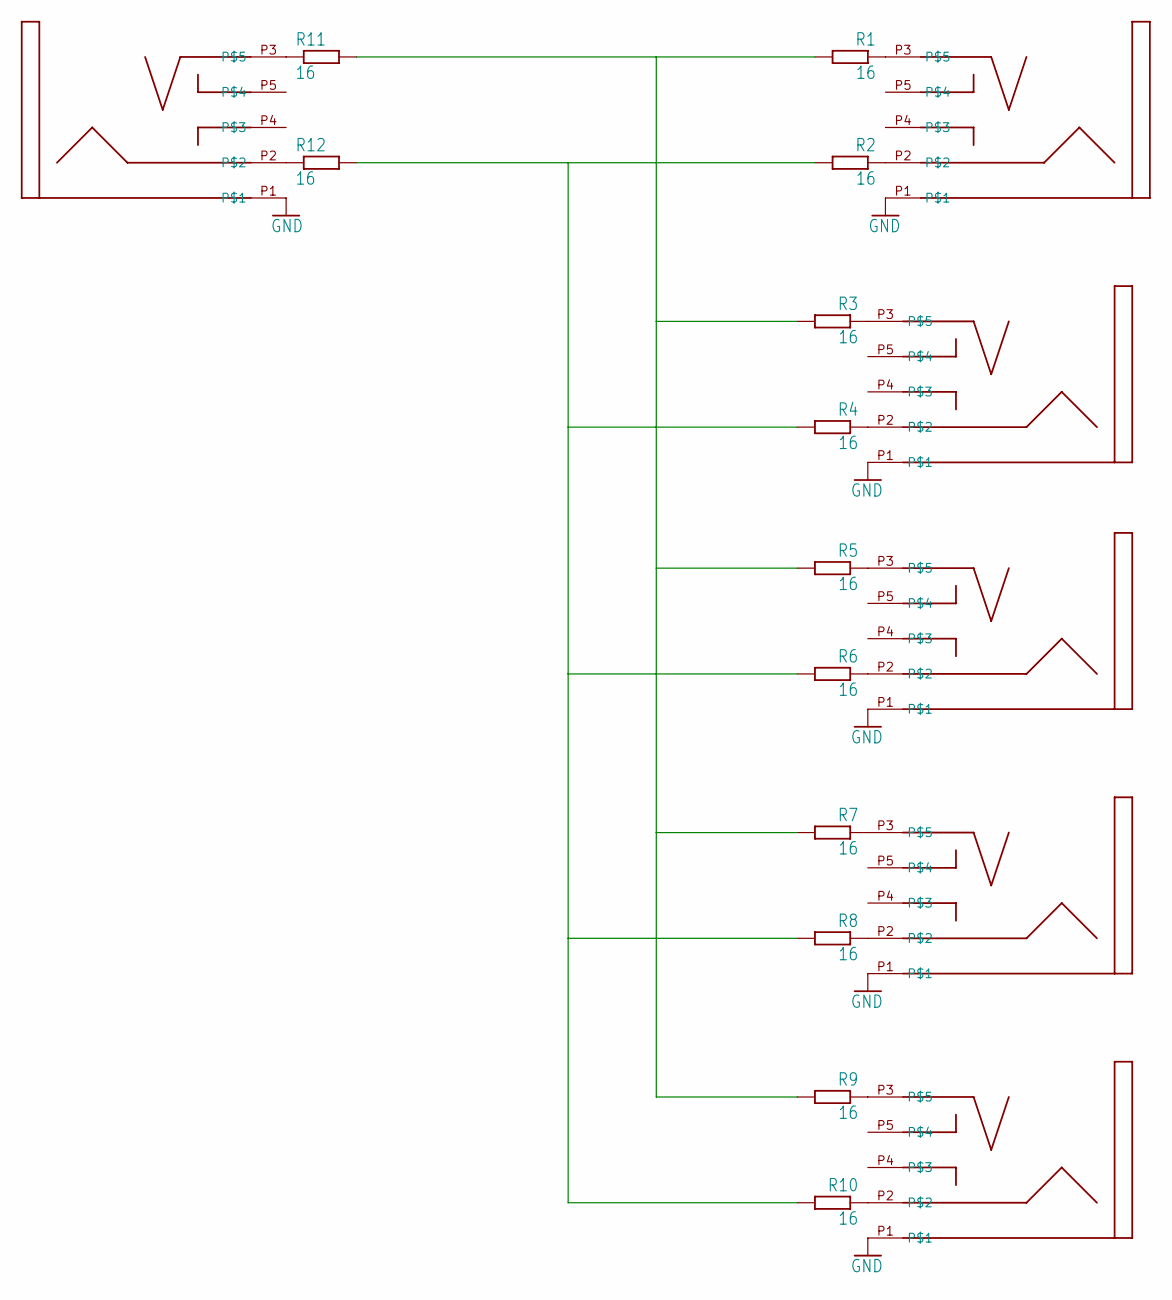
[picture p26: schematic 5port-headphone-belkin-clone-schnittplatz17.kicad_sch]

Parts:
IN0: MINIJACK-SMD; 502-35RASMT4BHNTRX
R1, R2, R3, R4, R5, R6, R7, R8, R9, R10, R11, R12: 16; R1206
U$1, U$2, U$3, U$4, U$5: MINIJACK-SMD; 502-35RASMT4BHNTRX

Connections:
GND: IN0.P1, U$1.P1, U$2.P1, U$3.P1, U$4.P1, U$5.P1
unnamed: R1.1, U$1.P3
unnamed: R2.1, U$1.P2
unnamed: R3.1, U$2.P3
unnamed: R4.1, U$2.P2
unnamed: R5.1, U$3.P3
unnamed: R6.1, U$3.P2
unnamed: R7.1, U$4.P3
unnamed: R8.1, U$4.P2
unnamed: R9.1, U$5.P3
unnamed: R10.1, U$5.P2
unnamed: IN0.P3, R11.1
unnamed: IN0.P2, R12.1
unnamed: R1.2, R3.2, R5.2, R7.2, R9.2, R11.2
unnamed: R2.2, R4.2, R6.2, R8.2, R10.2, R12.2

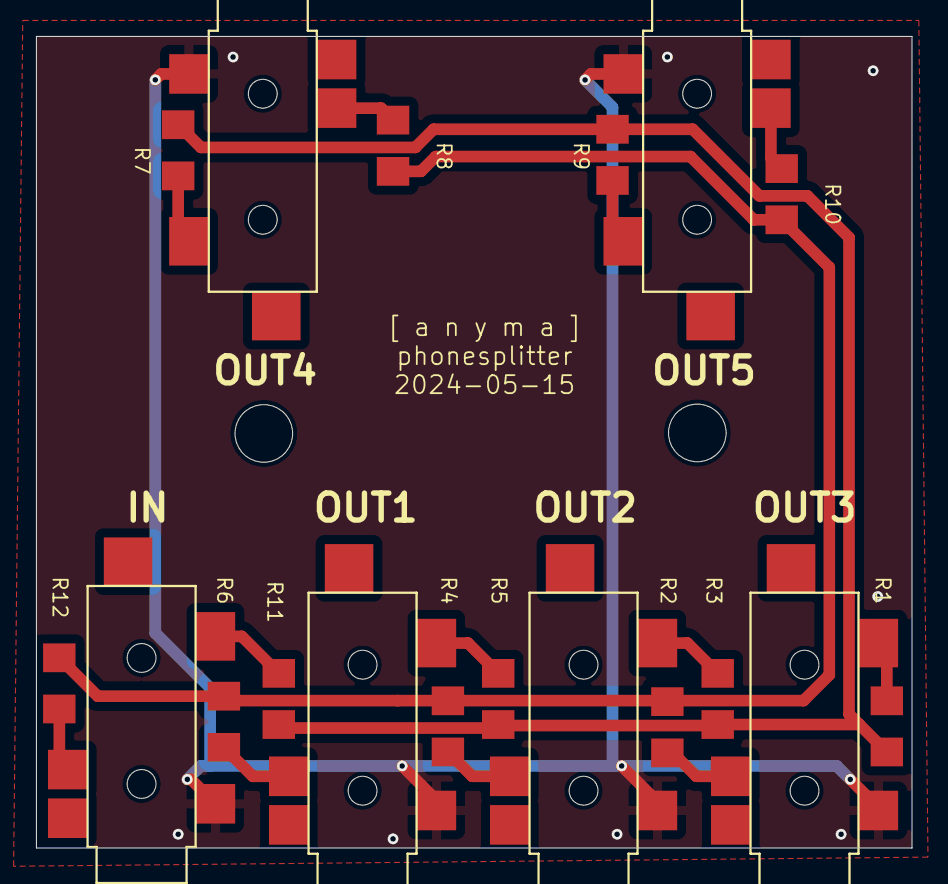
[picture p27: board 5port-headphone-belkin-clone-schnittplatz17.kicad_pcb from above]

Board: 2 copper layers, 48.6 x 45.1 mm, 20 parts (0 on the bottom side), 15 nets.

Other parts of the board:
@HOLE0, @HOLE1: (no value)
