mirdej/tvtools/kicad/tv.buzzer2022/tv.buzzer2022.kicad_pcb

## KiCad design kicad/tv.buzzer2022/tv.buzzer2022.kicad_pcb (2024-05-06)

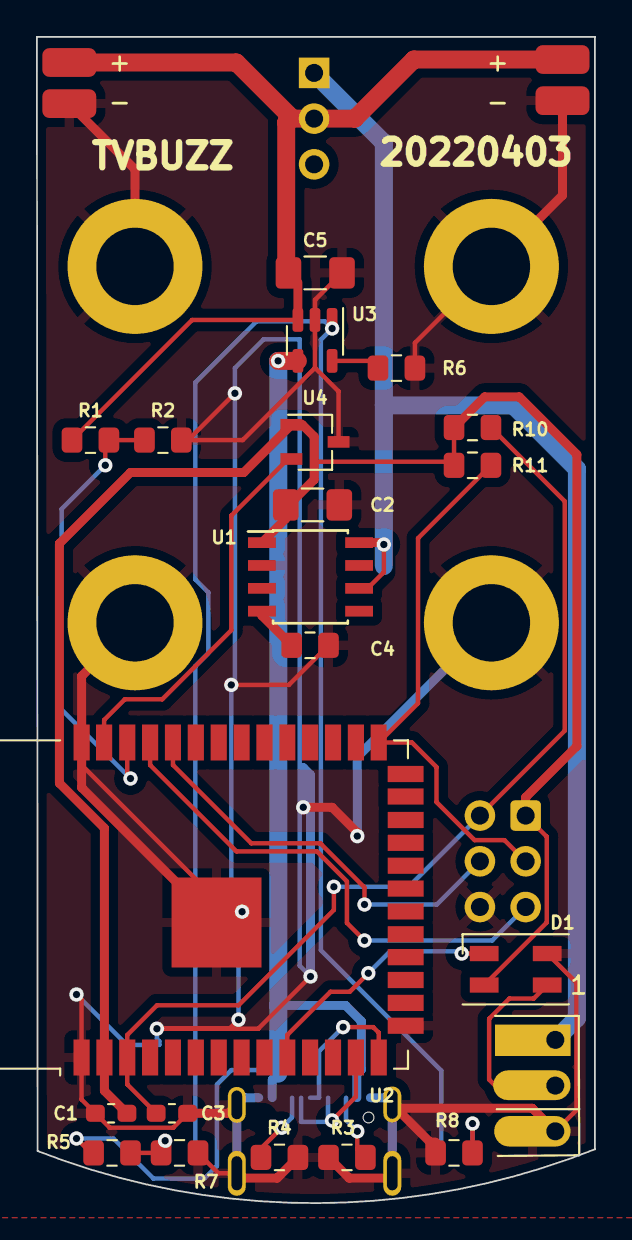
[picture p28: board tv.buzzer2022.kicad_pcb from above]

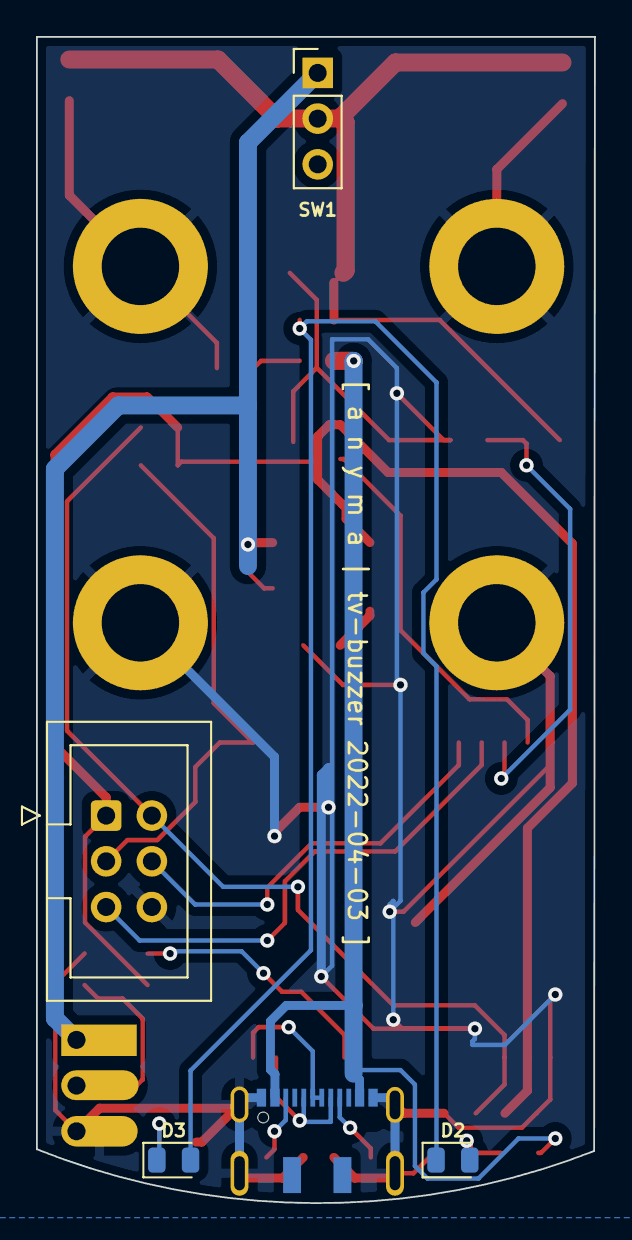
[picture p29: board tv.buzzer2022.kicad_pcb from below]

Board: 2 copper layers, 31.0 x 64.8 mm, 32 parts (5 on the bottom side), 22 nets.

Parts:
C1: 100n; C_0603_1608Metric_Pad1.05x0.95mm_HandSolder
C2: 10u; C_1206_3216Metric_Pad1.42x1.75mm_HandSolder
C3: 1u; C_0603_1608Metric_Pad1.05x0.95mm_HandSolder
C4: 470p; C_0805_2012Metric_Pad1.15x1.40mm_HandSolder
C5: CP; C_1206_3216Metric_Pad1.42x1.75mm_HandSolder
D1: SK6812MINI; LED_SK6812MINI_PLCC4_3.5x3.5mm_P1.75mm
D2: CHRG; LED_0805_2012Metric
D3: RDY; LED_0805_2012Metric
H1, H2, H3, H4: MountingHole_Pad; MountingHole_4.3mm_M4_DIN965_Pad
J1: USB_C_Receptacle_USB2.0; JAE_USB-C_SJ122205
J2: pixels; ComboPinhead_03
J3: CELL_1; smd-2pin
J4: Conn_01x06; IDC-Header_2x03_P2.54mm_Vertical
J5: CELL_2; smd-2pin
R1, R2: R; R_0805_2012Metric_Pad1.15x1.40mm_HandSolder
R3, R4: 5k1; R_0805_2012Metric_Pad1.15x1.40mm_HandSolder
R5, R6, R7, R8: 2k; R_0805_2012Metric_Pad1.15x1.40mm_HandSolder
R10, R11: 10k; R_0805_2012Metric_Pad1.15x1.40mm_HandSolder
SW1: SW_SPDT; PinHeader_1x03_P2.54mm_Vertical
U1: TC1263; SOIC-8_3.9x4.9mm_P1.27mm
U2: ESP32-S3-WROOM
U3: MCP73831-2-OT; SOT-23-5
U4: SS39ET-HallSensor; TSOT-23

Connections:
+3V3: C1.1, C2.1, D1.4 (VDD), J4.1, R10.1, R11.1, U1.1 (VOUT), U2.2 (VCC), U4.1 (VCC)
+3V8: J2.1, SW1.1 (A), U1.6 (!SHDN), U1.8 (VIN)
+5V: J1.A4 (VBUS), J1.A9 (VBUS), R5.1, U3.4 (VDD)
+BATT: C5.1, J3.1, J5.1, R1.1, SW1.2 (B), U3.3 (VBAT)
/en: C3.1, J4.2, R10.2, U2.3 (EN)
/flash: J4.3, R11.2, U2.27 (0)
/pix: D1.3 (DIN), U2.10 (17|U1TXD|AD2.6)
/rx: J4.4, U2.36 (44|RX)
/tx: J4.5, U2.37 (43|TX)
/usb+: J1.A6 (D+), J1.B6 (D+), U2.14 (20|U1CTS|AD2.9|USB-D+)
/usb-: J1.A7 (D-), J1.B7 (D-), U2.13 (19|U1RTS|AD2.8|USB-D-)
GND: C1.2, C2.2, C3.2, C4.2, C5.2, D1.2 (VSS), H1.1, H2.1, H3.1, H4.1, J1.A1 (GND), J1.A12 (GND), J1.S1 (SHIELD), J2.3, J3.2, J4.6, J5.2, R2.2, R3.2, R4.2, R6.2, R7.2, R8.2, U1.2 (GND), U2.1 (GND), U2.15 (03|T3|AD1.2), U2.40 (GND), U2.41 (GND), U3.2 (VSS), U4.3 (GND)
unnamed: C4.1, U1.4 (Bypass)
unnamed: D1.1 (DOUT), J2.2
unnamed: D2.1 (K), D3.2 (A), U3.1 (STAT)
unnamed: D2.2 (A), R5.2, R7.1
unnamed: D3.1 (K), R8.1
unnamed: J1.A5 (CC1), R3.1
unnamed: J1.B5 (CC2), R4.1
unnamed: R6.1, U3.5 (PROG)
unnamed: R1.2, R2.1, U2.38 (02|T2|AD1.1)
unnamed: U2.39 (01|T01|AD1.0), U4.2 (OUT)
