mirdej/tvtools/firmware/Lights/src/AnymaEspPins.h

#pragma ONCE

const int PIN_PIX = 18;

const int transmitPin = 17;
const int receivePin = 16;
const int enablePin = 21;
