mirdej/tvtools/firmware/Lights/src/AnymaEspNetworking.h

#ifndef __ANYMA_ESP_NETWWORKING_INCLUDED__
#define __ANYMA_ESP_NETWWORKING_INCLUDED__

#include <Arduino.h>
#include <Preferences.h>

#include "FS.h"
#include <LittleFS.h>

#include <ArduinoJson.h>
#include <WiFi.h>
#include <WiFiMulti.h>
#include <aWOT.h>
#include "MimeTypes.h"
#include <ESPmDNS.h>

#include "AnymaEspSettings.h"
#include "AnymaEspAPI.h"

#include "ESP-FTP-Server-Lib.h"
#include "FTPFilesystem.h"

#if USE_ETHERNET

#include <SPI.h>
#include <EthernetESP32.h>

#define IP1 192
#define IP2 168
#define IP3 252
#define IP_LIGHTS 249

IPAddress local_IP(IP1, IP2, IP3, IP_LIGHTS);
IPAddress gateway(IP1, IP2, IP3, 1);
IPAddress subnet(255, 255, 255, 0);
IPAddress primaryDNS(8, 8, 8, 8);   // optional
IPAddress secondaryDNS(8, 8, 4, 4); // optional

const int PIN_CS = 14;
const int PIN_SCK = 13;
const int PIN_MISO = 12;
const int PIN_MOSI = 11;
const int PIN_INT = 10;
const int W5500_RST_PORT = 9;
W5500Driver driver(PIN_CS, PIN_INT, W5500_RST_PORT);

#endif

#define ANYMA_ESP_SERVICE_NAME "anyma_esp32"
#define ANYMA_ESP_SERVICE_PORT 3101

#define WEBROOT "/webroot"
#define READ_BUFFER_SIZE 4096
const char *NTP_SERVER = "pool.ntp.org";
const char *TZ_STRING = "CET-1CEST,M3.5.0/2,M10.5.0/3";

WiFiMulti wifiMulti;
FTPServer ftp;
WiFiServer server(80);
Application app;

struct AnymaEspNetworking
{
public:
    void begin();
    int num_client_connections = 0;

private:
};

extern AnymaEspNetworking networking;

#if __APP_USE_CORS_HEADERS
void cors_headers(Request &req, Response &res)
{
    res.set("Access-Control-Allow-Origin", "*");
    res.set("Access-Control-Allow-Methods", "GET, POST, PUT, HEAD, OPTIONS");
    res.set("Access-Control-Allow-Headers", "Content-Type");
    //  log_v("_____________________\nPath %s, Method %d", req.path(), req.method());
    // res.status(204);
    if (req.method() == 7)
        res.sendStatus(204);
}
#endif

const char *indexFile = "/index.html";

/** ------------------------------------------------------------------------------------------------------------------------------------
 * @brief  Serve static files from MAIN_FILE_SYSTEM
 *
 *
 *
 * @param  req          aWot Request
 * @param  res          aWot Response
 */
void fileServer(Request &req, Response &res)
{
    long timestamp;
    if (req.method() != Request::GET)
    {
        return;
    }

    const char *path = req.path();

    if (strcmp(path, "/") == 0)
    {
        path = indexFile;
    }

    char local_path[120];
    strcpy(local_path, WEBROOT);
    strcat(local_path, path);

    log_v("Request file %s -> %s", path, local_path);

    if (!MAIN_FILE_SYSTEM.exists(local_path))
    {
        return;
    }

    File file = MAIN_FILE_SYSTEM.open(local_path);

    if (file.isDirectory())
    {
        file.close();
        return;
    }

    timestamp = millis();
    uint8_t readBuffer[READ_BUFFER_SIZE];
    const char *mimeType = MimeTypes::getType(file.name());
    res.set("Content-Type", mimeType);

    size_t length = file.size();

    while (length)
    {
        size_t toRead = length > READ_BUFFER_SIZE ? READ_BUFFER_SIZE : length;
        file.read(readBuffer, toRead);
        res.write(readBuffer, toRead);
        length = length - toRead;
        // log_v("%d",length);
        // vTaskDelay(pdMS_TO_TICKS(1));
        taskYIELD();
    }
    log_v("Took: %dms", millis() - timestamp);
    file.close();
    res.end();
}

void findFriends()
{
    int n = MDNS.queryService(ANYMA_ESP_SERVICE_NAME, "tcp");
    if (n == 0)
    {
        Serial.println("no friends found");
    }
    else
    {

        JsonDocument doc;

        Serial.print(n);
        Serial.println(" service(s) found");
        for (int i = 0; i < n; ++i)
        {
            JsonObject server_info;
            ;
            server_info["name"] = String(MDNS.hostname(i));
            Serial.println(MDNS.hostname(i));

            // server_info["ip"] = String(MDNS.IP(i).toString());
            server_info["port"] = String(MDNS.port(i));
            doc.add(server_info);
        }

        char data[2084];
        size_t len = serializeJson(doc, Serial);
    }
}

//----------------------------------------------------------------------------------------

#if USE_ETHERNET

bool setup_w5500()
{
    long startTime = millis();
    log_v("Setup network");

    WiFi.begin();
    WiFi.disconnect();

    SPI.begin(PIN_SCK, PIN_MISO, PIN_MOSI);

    Ethernet.init(driver);
    Ethernet.setHostname(settings.hostname.c_str());
    Ethernet.begin(local_IP, primaryDNS, gateway, subnet);

    /*
    Serial.println("Initialize Ethernet with DHCP:");x
      if Ethernet.begin())
     {
    //   Serial.print("  DHCP assigned IP ");
       Serial.println(Ethernet.localIP());
     }
     else
     {
       Serial.println("Failed to configure Ethernet  using DHCP");
       while (true)
       {
         delay(1);
       }
     } */

    log_v("Done. Time taken %d", millis() - startTime);
    return true;
}
#endif

//----------------------------------------------------------------------------------------
//																				                                       WiFi Task
void TaskClientSocket(void *pvParameters)
{
    WiFiClient clientHandle = *((WiFiClient *)pvParameters);
    int client_id = networking.num_client_connections++;

    if (clientHandle.connected())
    {
        //   log_v("New Client Connected. Client#: %d", client_id);
        app.process(&clientHandle);
        clientHandle.stop();
    }
    //  log_v("Client #%d disconnected", client_id);
    networking.num_client_connections--;
    vTaskDelete(NULL);
}

void network_task(void *)
{
    long last_mdns_lookup; //= millis();
    configTime(0, 0, NTP_SERVER);
    setenv("TZ", TZ_STRING, 1);
    tzset();

    WiFi.config(INADDR_NONE, INADDR_NONE, INADDR_NONE, INADDR_NONE);
    WiFi.setHostname(settings.hostname.c_str());

#if USE_ETHERNET
        WiFi.setAutoReconnect(false);
        setup_w5500();

#else

    WiFi.mode(WIFI_STA);
    WiFi.setSleep(false); // better resonsiveness, more power consumption
    // wifiMulti.addAP(settings.ssid.c_str(), settings.pass.c_str());
    wifiMulti.addAP("Anymair", "Mot de passe pas complique");

    while (WiFi.status() != WL_CONNECTED)
    {
        wifiMulti.run();
        vTaskDelay(pdMS_TO_TICKS(250));
    }
    log_i("IP address: %s", WiFi.localIP().toString().c_str());
#endif

    // From WLED:
    //  "end" must be called before "begin" is called a 2nd time
    //  see https://github.com/esp8266/Arduino/issues/7213
    MDNS.end();
    if (!MDNS.begin(settings.hostname.c_str()))
    {
        log_e("Error setting up MDNS responder!");
    }
    else
    {
        log_i("mDNS responder started");
        log_i("Hostname: %s", settings.hostname);
        MDNS.addService("http", "tcp", 80);
        MDNS.addService("ftp", "tcp", 21);
        MDNS.addService(ANYMA_ESP_SERVICE_NAME, "tcp", ANYMA_ESP_SERVICE_PORT);
#if USE_ETHERNET
        MDNS.addServiceTxt(ANYMA_ESP_SERVICE_NAME, "tcp", "mac", ETH.macAddress().c_str());
        MDNS.addServiceTxt(ANYMA_ESP_SERVICE_NAME, "tcp", "connection", "ethernet");

#else
        MDNS.addServiceTxt(ANYMA_ESP_SERVICE_NAME, "tcp", "mac", WiFi.macAddress().c_str());
        MDNS.addServiceTxt(ANYMA_ESP_SERVICE_NAME, "tcp", "connection", "wifi");
#endif
    }

    findFriends();

#if __APP_USE_CORS_HEADERS
    app.use(&cors_headers);
#endif

    setup_api();
    app.get(&fileServer);

    server.begin();

    log_i("Webserver started.");

    ftp.addUser(FTP_USER, FTP_PASSWORD);
    ftp.addFilesystem("LittleFS", &LittleFS);
    ftp.begin();
    log_i("FTP server started.");

    while (1)
    {
        if (USE_ETHERNET || WiFi.status() == WL_CONNECTED)
        {

            if (millis() - last_mdns_lookup > 60000)
            {
                findFriends();
                last_mdns_lookup = millis();
            }

            ftp.handle();

            WiFiClient client = server.available();
            if (client.connected())
            {
                app.process(&client);
            }

            vTaskDelay(pdMS_TO_TICKS(1));
        }
        else
        {
            Serial.println("[WIFI] Connecting");
            WiFi.reconnect();
            vTaskDelay(pdMS_TO_TICKS(1000));
        }
    }
}

void AnymaEspNetworking::begin()
{

    /*  xTaskCreatePinnedToCore(
                                network_task, "WIFI", 16384, NULL, 1, NULL, 0); */

    xTaskCreate(
        network_task, // Function that implements the task.
        "Network",    // Text name for the task.
        16384,        // Stack size in words, not bytes.
        NULL,         // Parameter passed into the task.
        0,            // Priority at which the task is created.
        NULL);
}

#endif
