mirdej/tvtools/(commit log)

2010-02-13 launchpad: added reload button
2010-05-27 initial commit of first experimental edit amp boards
    [headphone_amp.brd, headphone_amp.sch, mic_amp.brd, mic_amp.sch, speaker_amp.brd, speaker_amp.sch, usb_interface.brd, usb_interface.sch]
2010-05-27 headphone amp with pot between amp and phones
    [headphone_amp.brd, headphone_amp.sch]
2010-05-29 usb + 4 hp aps on one board. there's hiss and volume control is strange. will redo design
    [mic_amp.brd, mic_amp.sch, usb_hp_dist_amp.brd, usb_hp_dist_amp.sch]
2012-04-23 added schematics for intercom node
    [node-rj45-board.brd, node-rj45-board.sch, node_mainboard.brd, node_mainboard.sch]
2012-04-23 replaced headphone diff-amp with INA134
    [node-rj45-board.brd, node-rj45-board.sch]
2012-04-24 corrections on main board, added 75176 transceiver
    [node-rj45-board.brd, node-rj45-board.sch, node_mainboard.brd, node_mainboard.sch]
2012-04-24 added encloser plans. added preliminary mic preamp. mic preamp now gets poer and signal from rj45-board
    [node-mic-preamp.brd, node-mic-preamp.sch, node-rj45-board.brd, node-rj45-board.sch]
2012-04-24 replaced 4k7 with 6k8 resistors
    [node-rj45-board.brd, node-rj45-board.sch, node_mainboard.brd, node_mainboard.sch]
2012-04-24 correct resistor values on main board
    [node_mainboard.brd, node_mainboard.sch]
2012-04-24 optimized routing and added mounting hole
    [node_mainboard.brd]
2012-12-13 added speedlimit to midiinput for button debouncing
2013-01-02 first version of regie intercom node
    [node_mainboard.brd, regie-intercom-node.brd, regie-intercom-node.sch]
2013-01-04 added more modules
    [hub-4xvideo.brd, hub-4xvideo.sch, hub-bus.brd, hub-bus.sch, hub-channel.brd, hub-channel.sch, hub-upstream-module.brd, hub-upstream-module.sch]
2013-01-05 more compact version
    [regie-intercom-node-with-video.brd, regie-intercom-node-with-video.sch]
2013-01-12 shitty version used to film the opera
    [node-video-only.brd, node-video-only.sch, regie-intercom-node-with-video.brd]
2013-01-19 separate board for all audio stuff. filered phantom power. almost no hum anymore. production version?
    [node-audio.brd, node-audio.sch, node-mic-preamp.brd, node-mic-preamp.sch, node-rj45-board.brd, node-rj45-board.sch, node_mainboard.brd, node_mainboard.sch]
2013-01-19 forgot a resistor on audio board. added firmware
    [node-audio.brd, node-audio.sch, node_mainboard.brd]
2013-01-29 built like this, missing 20k resistor to tie down lm833 input from microphone
    [node_mainboard.brd, node_mainboard.sch, regie-intercom-2.brd, regie-intercom-2.sch, regie-upstream-module.brd, regie-upstream-module.sch]
2013-01-29 added enclosures
2013-02-12 first version of regie channel with video out
    [regie-channel.brd, regie-channel.sch]
2013-02-12 regie channel video receiver based on EL5175
    [regie-channel.brd, regie-channel.sch]
2013-02-13 discovered major design error: Pairs on a Cat5e - RJ45 jack are pins 1+2 / 3+6 / 4+5 / 7+8 - not straight trough. corrected node and regie boards - todo: new hub. Now it's crystal clear why we always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
    [node-rj45-board.brd, node-rj45-board.sch, regie-channel.brd, regie-channel.sch]
2013-02-15 for regie and node - this is the version that has been built and tested as of fev 15 2013. new regie bus with external mixer module. new audio xlr ou module for recording. Hub has to be redone to cor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
    [regie-audio-out.brd, regie-audio-out.sch, regie-bus.brd, regie-bus.sch, regie-mixer.brd, regie-mixer.sch, regie-supply2.brd, regie-supply2.sch]
2013-06-02 added suppiort for logitech presenter remote. corrected movie frame calculation for presentation mode
2014-01-09 corrected hub. added simplified 4 channel switcher
    [hub-4xvideo.brd, hub-4xvideo.sch, hub-bus.brd, hub-bus.sch, hub-channel.sch, hub-upstream-module.brd, hub-upstream-module.sch, node-audio.sch]
2014-01-09 selects cam 1 on power up. cleaned up code
2014-12-29 redesign of switch with 4053 and USB - no pcb layout yet. (could not find board from last year, cant remember why it didnt work)
    [regie-switch.brd, regie-switch.sch]
2014-12-30 new board layout. adapted firmware. untested
    [regie-switch.brd, regie-switch.sch]
2015-01-01 added picture snapping, session for current project, deleting of members
2015-01-03 create, delete, modify groups. add camera to group by dragndrop
2015-01-03 can add cameras and members to groups. cannot remove members yet
2015-01-06 liste der lüste works
2015-01-06 ide logo when printing badges ad spick
2015-01-15 click on badge to only show/print this one
2015-01-21 automatically generate logfiles with internal millisecond timer, starting when first clip is launched
2015-01-21 more spacing for posten/lueste. correct printing of badges on card-printer
2015-02-01 added gnuswitch camera cut logging
2016-02-27 add switch control over usb
    [regie-intercom-2.brd]
2016-05-29 switched to me
2017-06-20 add sync flash signal. change recording filename so they get inserted at end of list
2017-06-20 max crashed. again: add sync flash signal. change recording filename so they get inserted at end of list
2019-05-14 visual camera assignment
2020-02-15 complete rework while switching to Blackmagic devices
    [DeckController-Hardware.kicad_pcb, DeckController-Hardware.sch, RecorderRack.skp, SwitcherController-Enclosure.skp, headphone_amp.brd, headphone_amp.sch, hub-4xvideo.brd, hub-4xvideo.sch]
2020-09-08 fix ip adresses, fix remaining time error (ignore hours in timecode)
    [SwitcherController-Enclosure.skp]
2021-04-11 fix cras on talk end
    [Switcher-Controller-Talk.ino, hyperdeck.py]
2021-04-11 reset setup after watching before new talk
    [Switcher-Controller-Talk.ino]
2022-07-13 fix connection issue. ESP2.0.4, Ethernet.h @ 2.0.1. add titler handling, change ip to 192.168.252.200
    [Switcher-Controller-Talk.ino]
2022-08-24 switch to new dmx library
2024-05-06 add missing files
    [ClipController23.skp, ClipController23~.skp, TV-BUZZER-2022.skp, TV-BUZZER-2022.stl, TV-BUZZER-2022~.skp, TV_BUZZER2022.2.skp, TV_BUZZER2022.2~.skp, TV_BUZZER2022.3.skp]
2024-05-06 import blink2024 as basis for new lights
    [HugeFS_16MB.csv]
2024-05-11 try to improve webserver stability
    [AnymaEspNetworking.h, AnymaEspPins.h]
2024-05-15 import from old eagle backp
    [5port-headphone-belkin-clone-schnittplatz17.kicad_pcb, 5port-headphone-belkin-clone-schnittplatz17.kicad_sch]
2024-05-15 reroute for fab
    [5port-headphone-belkin-clone-schnittplatz17.kicad_pcb]
2024-05-15 tv-controller reroute for fab
    [5port-headphone-belkin-clone-schnittplatz17.kicad_pcb, bm-tally.kicad_pcb, bm-tally.kicad_sch, tv.controller2023-B_Cu.dxf, tv.controller2023-B_Mask.dxf, tv.controller2023-B_Paste.dxf, tv.controller2023-B_Silkscreen.dxf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]
2024-05-28 easy switching between ETH/WiFi
2025-03-18 move to platformio
    [HugeFS_16MB.csv]
2025-03-22 change buzzers to esp-now
    [main.cpp]
2025-03-26 new calibration, still acciodental triggers
2025-03-26 trigger in middle
    [TV-BUZZER-2022.skp, TV-BUZZER-2022~.skp]
2025-03-26 use avg only on startup, then fixed polarity
    [main.cpp]
2025-04-22 new buzzer version
    [HugeFS_16MB.csv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]
2025-04-22 powersaving leds
    [tv25-cpu.kicad_sch]
2025-04-24 new buzzers
    [TV-BUZZER-2022.skp, TV-BUZZER-2022.stl, TV-BUZZER-2022~.skp, TV_BUZZER2022.2.skp, TV_BUZZER2022.2~.skp, TV_BUZZER2022.3.skp, tv-buzzer-case.skp, tv-buzzer-case~.skp]
2025-05-18 remove prints
2025-05-29 nav changes
    [HugeFS_16MB.csv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]
