mirdej/tvtools/(notices)

Notices in the files:
firmware/Switcher2025/src/main.cpp:
Copyright: 2019 Michael Egger, me@anyma.ch
License: This is FREE software (as in free speech, not necessarily free beer)
published under gnu GPL v.3
firmware/TV-Buzzer-Firmware/TV-Buzzer-Firmware.ino:
Copyright: 2022 Michael Egger, me@anyma.ch
firmware/TV.QuizControl/src/main.cpp:
Copyright: 2023 Michael Egger, me@anyma.ch
